Dongmins11/KickCAN_project_Controller/docs/functions.md

# 시스템 기능 명세

[README로 돌아가기](../README.md) · [원본 Excel](files/functional-spec.xlsx)

원본 Excel의 셀 내용을 Markdown 표로 옮겼습니다. 설계 당시의 값·표기이며, 실제 Controller 구현과 다른 부분은 아래에 별도로 적었습니다. 원본의 서식과 삽입 그림은 Excel 파일에서 확인할 수 있습니다.

## RC카 시스템 기능 명세서

| 노드 구분 | 기능 ID | 기능명 | 입력 인터페이스 | 주요 처리 로직 (기능 내용) | 출력 인터페이스 | 통신인터페이스 | 비고 |
|---|---|---|---|---|---|---|---|
| Controller | F-CTL-01 | RFID 기반 차량 보안 인증 (스마트키) | RC522 RFID 모듈 (SPI) | 등록된 카드/태그의 UID 값을 읽어 시동 허가(AUTH_OK) 여부 판단 | 인증 실패 시 모든 조종 명령 송신 차단 (시동 잠금) | 블루투스로 AUTH_FALE 상태 전송 | — |
| Controller | F-CTL-02 | 스마트키 인증 기반 입력 전원 인터락 | — | RFID 인증 결과에 따라 릴레이 구동<br>인증 실패 시 조작 입력 차단 | 조이스틱·스위치 입력단 전원 (게이팅된 신호) | — | — |
| Controller | F-CTL-03 | 주행 및 조향 데이터 수집 | 2축 아날로그 조이스틱 (ADC) | X축/Y축 아날로그 입력값(0~4095)을 정수형 속도(-100~100) 및 조향 각도 데이터로 매핑 | 무선 전송용 데이터 | 블루투스로 조이스틱 adc 데이터 전송 | — |
| Controller | F-CTL-04 | 차량 제어 스위치 입력 처리 | 3단 토글 스위치, 푸시 택트 스위치 (GPIO) | 좌/우 방향지시등 선택 상태 및 클락션 등 부가 기능 버튼 입력 상태 감지 | 스위치 상태 플래그 | 블루투스로 좌/우 방향지시등, 클락션 등 제어명령 전송 | — |
| Controller | F-CTL-05 | 무선 데이터 패킷 전송 | 인증 상태 / 주행·조향값 / 스위치 상태 | 패킷 가공 후 주 주기(예: 20ms) 전송 | 블루투스 모듈 HC-05 (UART) | — | 추가 |
| Controller | F-CTL-06 | 시리얼 디버깅 | 블루투스  | 각종 상태 명령 시리얼 모니터로 감시 | UART | 블루투스로 main_node에서 받은 각종 상태를 받아 uart포트로 점검한다. | 추가 |
| Main_Node | F-MAIN-01 | 무선 명령 수신 및 파싱 | 블루투스 모듈 HC-06 (UART) | 수신 패킷 검증 및 파싱 (체크섬 확인) | 내부 제어 명령 데이터 | 블루투스로 인증상태 방향지시등 비상등 클락션등 제어명령 수신 | — |
| Main_Node | F-MAIN-02 | 4WD 모터 구동 및 방향 제어 | 수신된 속도 및 조향 명령 | 속도 데이터로 PWM duty cycle 조절, 방향에 따른 정/역회전 제어 | L298N 모터드라이버 및 DC 모터 4개 (PWM, GPIO) | 블루투스로 controller에서 adc 데이터를 수신 | — |
| Main_Node | F-MAIN-03 | 배터리 전압 감시 | 18650 2S 배터리 저항 분압 회로 (ADC) | 배터리 전압(V) 및 잔량 퍼센트(%) 계산 수 100ms마다 Node_2로 전송 | 배터리 상태 데이터 | CAN으로 베터리 데이터 node_2로 전송 | — |
| Main_Node | F-MAIN-04 | 속도 측정 | 엔코더 포토커플러 | 속도 측정 후 100ms마다 측정된 속도 Node_2로 전송 | 속도 데이터 (m/s) | CAN으로 속도 데이터 node_2로 전송 | — |
| Main_Node | F-MAIN-05 | 전,후,정지 상태 업데이트 | 아날로그 스틱 or 속도 | 아날로그 스틱 혹은 속도를 측정하여 전진 후진 정지 감지 | 전진 후진 정지  | CAN으로 전진 후진 정지 상태 node2로 전송 | 추가 |
| Main_Node | F-MAIN-06 | CAN 전송 | 데이터 패킷 | 수십 ms 주기로 CAN 메시지 방송 | 캔 트렌시버 | — | — |
| Main_Node | F-MAIN-07 | CAN node 연결 상태 확인 | node ACK신호  | 모든 노드의 아이디로 cheak명령 전송 | 캔 트렌시버 | CAN으로 모든 노드 cheak명령 전송 및 블루투스로 통신 연결 상태 전송 | 추가 |
| Node_1 | F-SEN-01 | 모터 온도 감시 및 Thermal Throttling | TMP36(ADC) | 모터 컨트롤러 표면 온도(°C) 계산, 위험 온도(60°C 이상) 진입 시 과열 경고 전송 | CAN 버스 메시지 (과열 경고) | CAN으로 과열 경고  node_2로 전송 | — |
| Node_1 | F-SEN-02 | 2채널 오토 라이트 (Auto Light) 환경 감지 | 전방 CdS 센서 + 상부 CdS 센서 (ADC) | 전방 광량과 상부 광량 비교 분석하여 터널 진입 및 밤/낮 상태 판별 | CAN 버스 메시지 (헤드라이트 제어) | CAN으로 조도 상태(어두움, 밝음)  node_2로 전송 | — |
| Node_1 | F-SEN-03 | 전후방 장애물 거리 측정 | HC-SR04 초음파 센서 2개 (TIM_IC / GPIO) | 앞/뒤 센서 거리(cm) 정밀 측정 | 전후방 거리 데이터 | CAN으로 장애물에 대한 1, 2, 3단계 상태  node_2로 전송 | — |
| Node_1 | F-SEN-04 | CAN 전송 | 데이터 패킷 | 수십 ms 주기로 CAN 메시지 방송 | 캔 트렌시버 | — | — |
| Node_1 | F-SEN-05 | CAN node 연결 상태 확인 | node ACK신호  | 모든 노드의 아이디로 cheak명령 전송 | 캔 트렌시버 | main에서 cheak명령 수신 및 ack 전송 | 추가 |
| Node_2 | F-HCI-01 | TFT 메인 그래픽 클러스터 렌더링 | CAN 버스 수신 데이터 (속도/배터리/방향지시등) | 속도계, 배터리 잔량 바, 방향지시등 화살표 아이콘 실시간 그래픽 출력 | 2.2인치 240x320 TFT LCD ×2 (SPI) | 속도, 배터리 데이터를 main_node에서 수신 | — |
| Node_2 | F-HCI-02 | CLCD 서브 정보창 출력 | CAN 버스 수신 데이터 (온도/초음파거리/스마트키상태) | 모터 온도(°C) 상태, 초음파 거리(cm), 스마트키 상태(LOCKED/WELCOME) 텍스트 및 이미지 출력 | 16x2 I2C CLCD (I2C) | 센서 데이터를 node_1에서 수신 | — |
| Node_2 | F-HCI-03 | 턴 시그널 및 오토라이트 제어 | CAN 버스 수신 데이터 (방향지시등/오토라이트 명령) | 방향지시등 좌/우 점멸, 헤드라이트(오토라이트) 점등 | 방향지시등 빨간색 LED (좌/우)<br>헤드라이트 노란색 LED (좌/우) | 제어 명령를 main_node에서 수신 | — |
| Node_2 | F-HCI-04 | 청각 경고음 출력 (Fail-safe 피드백) | CAN 버스 수신 데이터 (과열경고/초근접/스마트키인증) | 모터 과열 경고, 후방 초근접(20cm 이내), 인증 성공/실패 시 비프음 출력 | 부저 | 센서 데이터를 node_1에서 수신 | — |
| Node_2 | F-HCI-05 | CAN 전송 | 데이터 패킷 | 수십 ms 주기로 CAN 메시지 방송 | 캔 트렌시버 | — | 추가 |
| Node_2 | F-MAIN-06 | CAN node 연결 상태 확인 | node ACK신호  | 모든 노드의 아이디로 cheak명령 전송 | 캔 트렌시버 | main에서 cheak명령 수신 및 ack 전송 | 추가 |

## 현재 코드와의 차이

Controller 원본의 0–4095 및 -100–100 매핑 설명은 현재 코드와 다릅니다. 현재 코드는 10-bit ADC(0–1023), EMA 필터와 끝값 보정을 사용합니다. 인증 실패 알림은 최초 잠금 상태와 연결 이후 실패 상태에 따라 다릅니다. F-CTL-06은 원본의 계획 항목이며 Bluetooth 테스트 Task의 호출은 현재 주석 처리되어 있습니다. 전체 노드의 모든 계획 항목을 구현 완료로 간주하지 않습니다.
