Dongmins11/KickCAN_project_Controller/docs/files/presentation.pdf

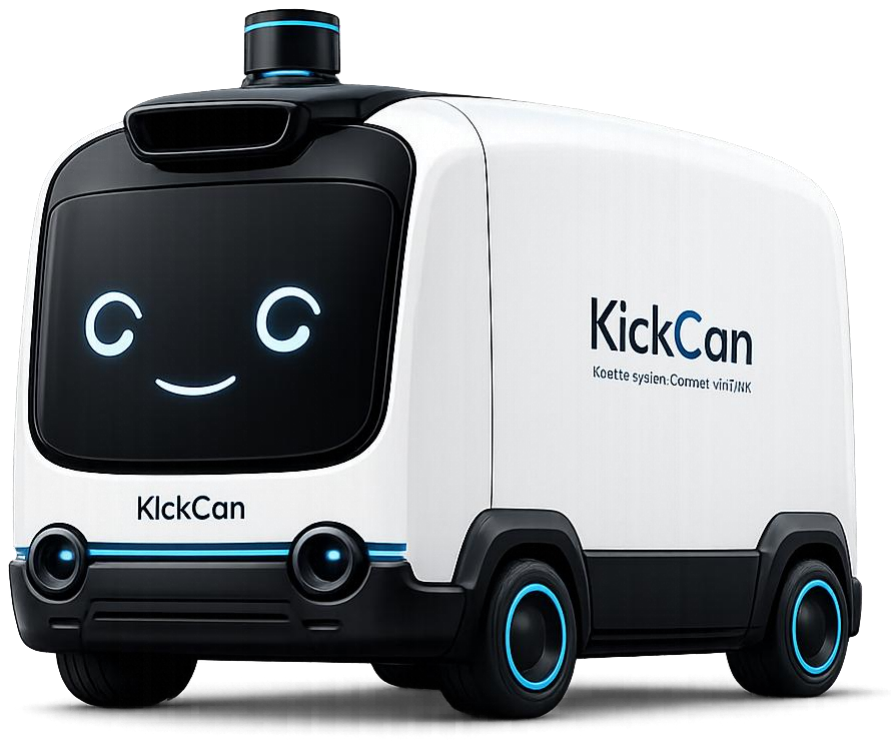
[picture p11: figure]

## Cortex

M

## Mini PROJECT

CAN 통신을 이용한 RC

카

팀명 : 깡통차기 [Kick CAN]

CAN
SENSOR
FreeRTOS
Bluetooth
ADC
DMA
PWM

목 차

### 01 프로젝트 소개

### 02 시연 영상

### 03 프로젝트 상세 내용

### 04 CAN 통신

### 05 트러블 슈팅 사례

### 06 향후 과제

### 07 Q & A

# 01 프로젝트 소개

프로젝트 소개

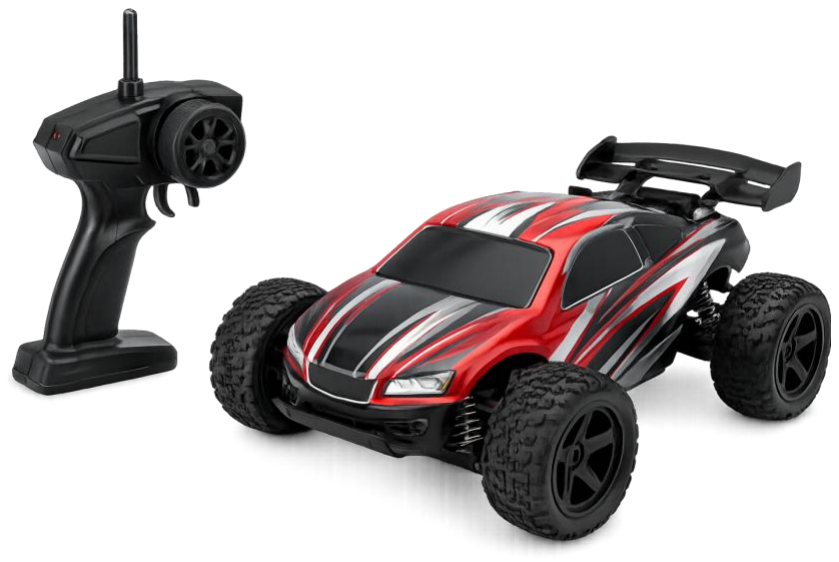
[picture p12: figure]

원격 주행이 가능한 기존의 RC카

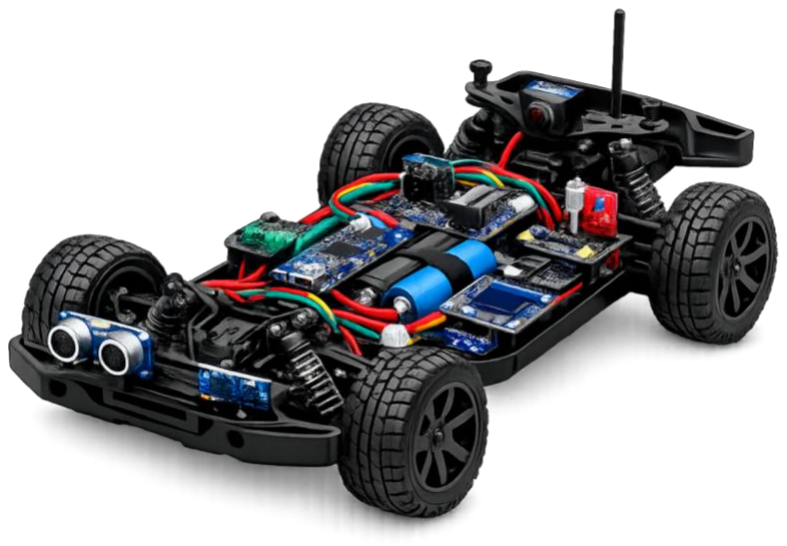
[picture p13: figure]

실제 차량의 전장 시스템을 모사
운전자 입력, 차량 제어,
주변 환경 감지, 경고 및 정보 표시

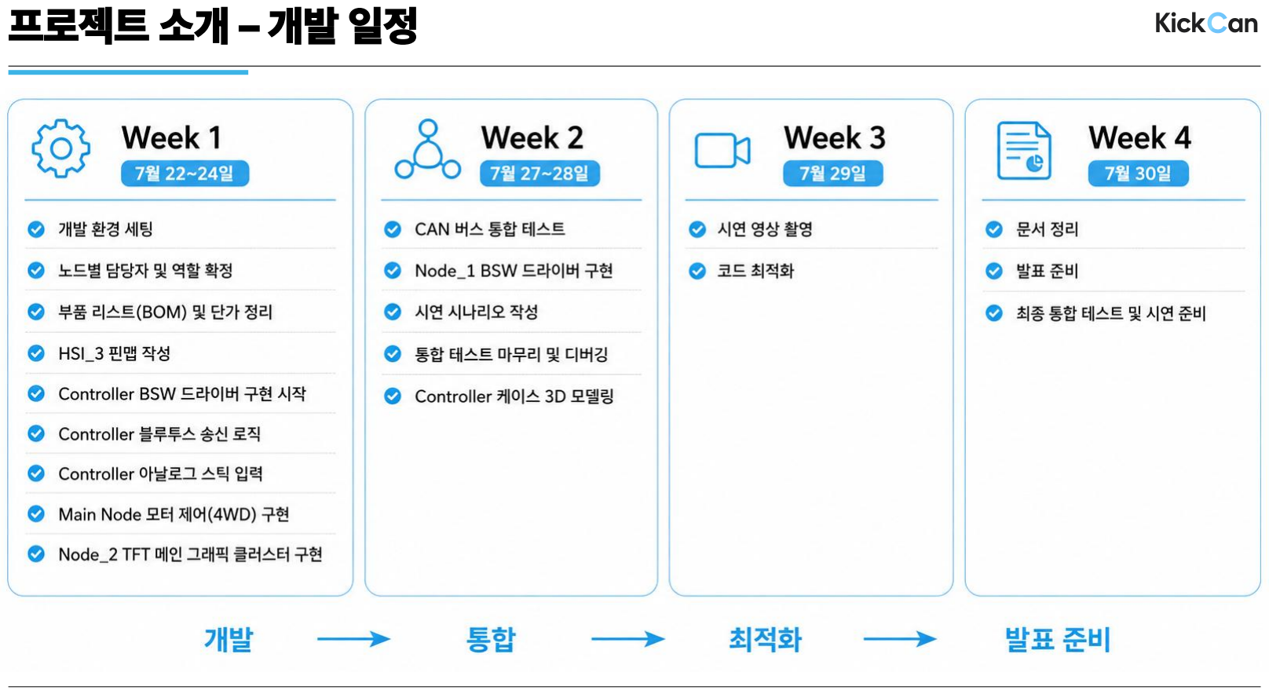
[picture p14: page 5]

프로젝트 소개 – 개발 일정

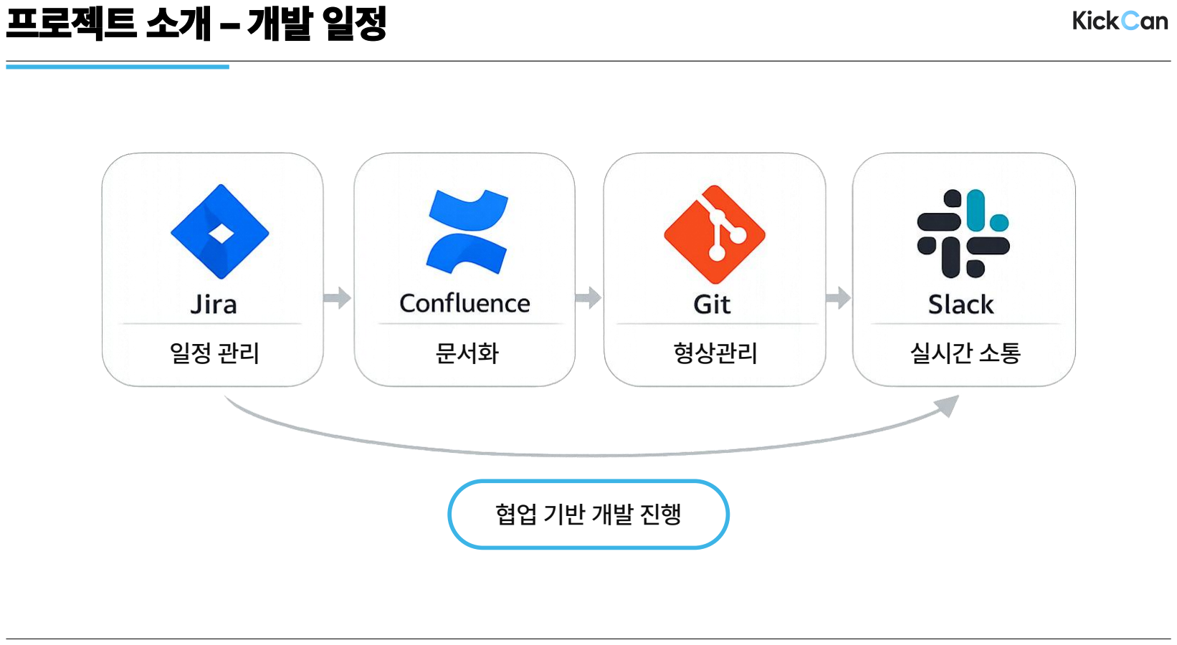
[picture p15: page 6]

프로젝트 소개 – 개발 일정

일정 관리 | 문서화 | 형상관리 | 실시간 소통

협업 기반 개발 진행

프로젝트 소개 - 팀원

최은비
[Node 1]
✓ | 초음파 , 온도 등 센서 데이터 수집
✓ | FreeRTOS 기반 Task 구조
✓ | CAN 송신 데이터 관리

최세은
[Node 2]
✓ | TFT·CLCD 차량 상태 시각화
✓ | PWM 기반 헤드라이트·부저 제어
✓ | CAN 수신 데이터 기반 경고·상태
| 관리

신동민
[Controller]
✓ | 주행 및 조향 데이터 수집
✓ | 차량 제어 스위치 입력 처리
✓ | RFID 기반 차량 보안 인증

이정훈
[Main Node]
✓ | 통신 관련 명령 수신 및 파싱
✓ | 4WD 구동 제어
✓ | 상태 감시 및 공유

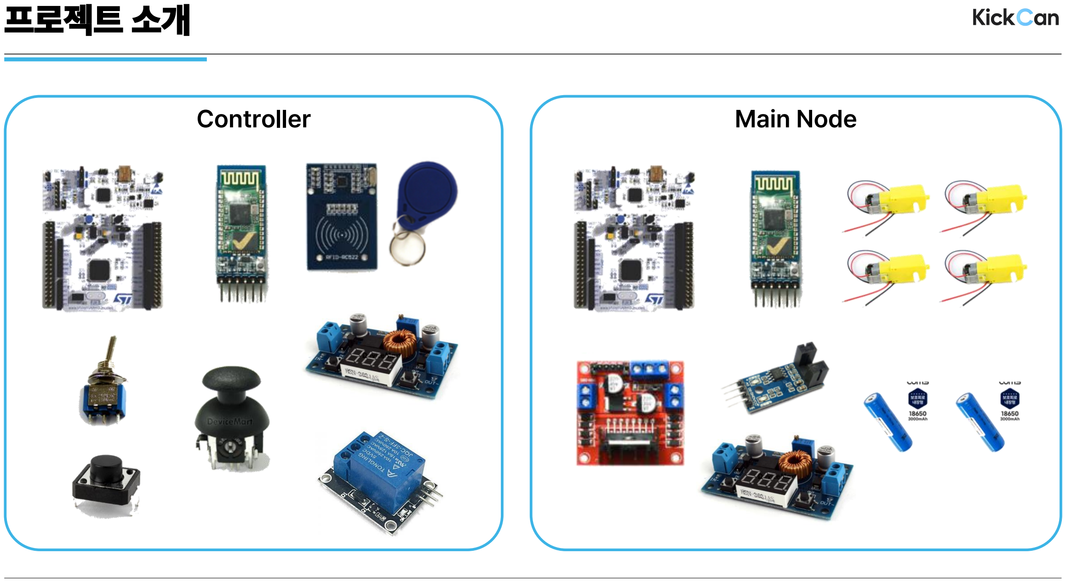
[picture p16: page 8]

프로젝트 소개

Controller | Main Node

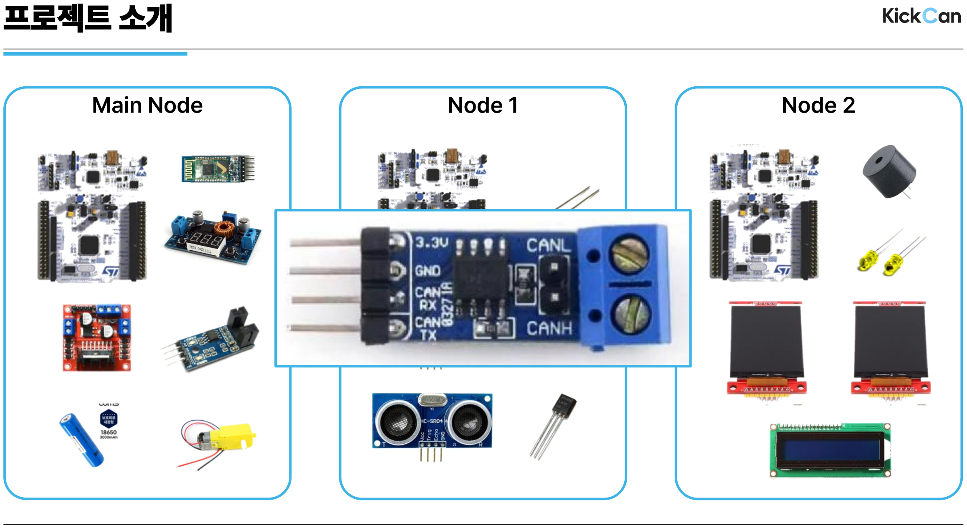
[picture p17: page 9]

프로젝트 소개

Main Node | Node 1 | Node
2

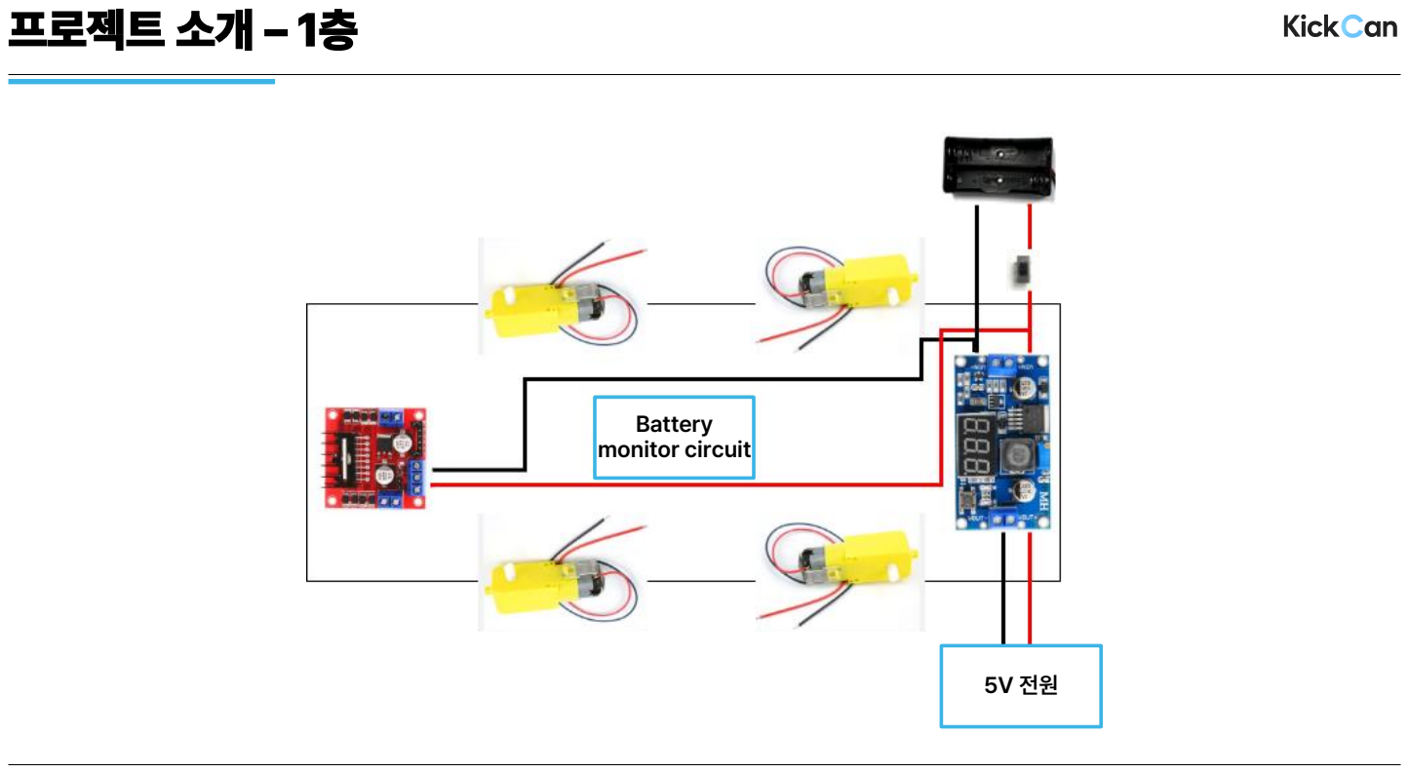
[picture p18: page 10]

프로젝트 소개 – 1층

Battery
monitor circuit

5V 전원

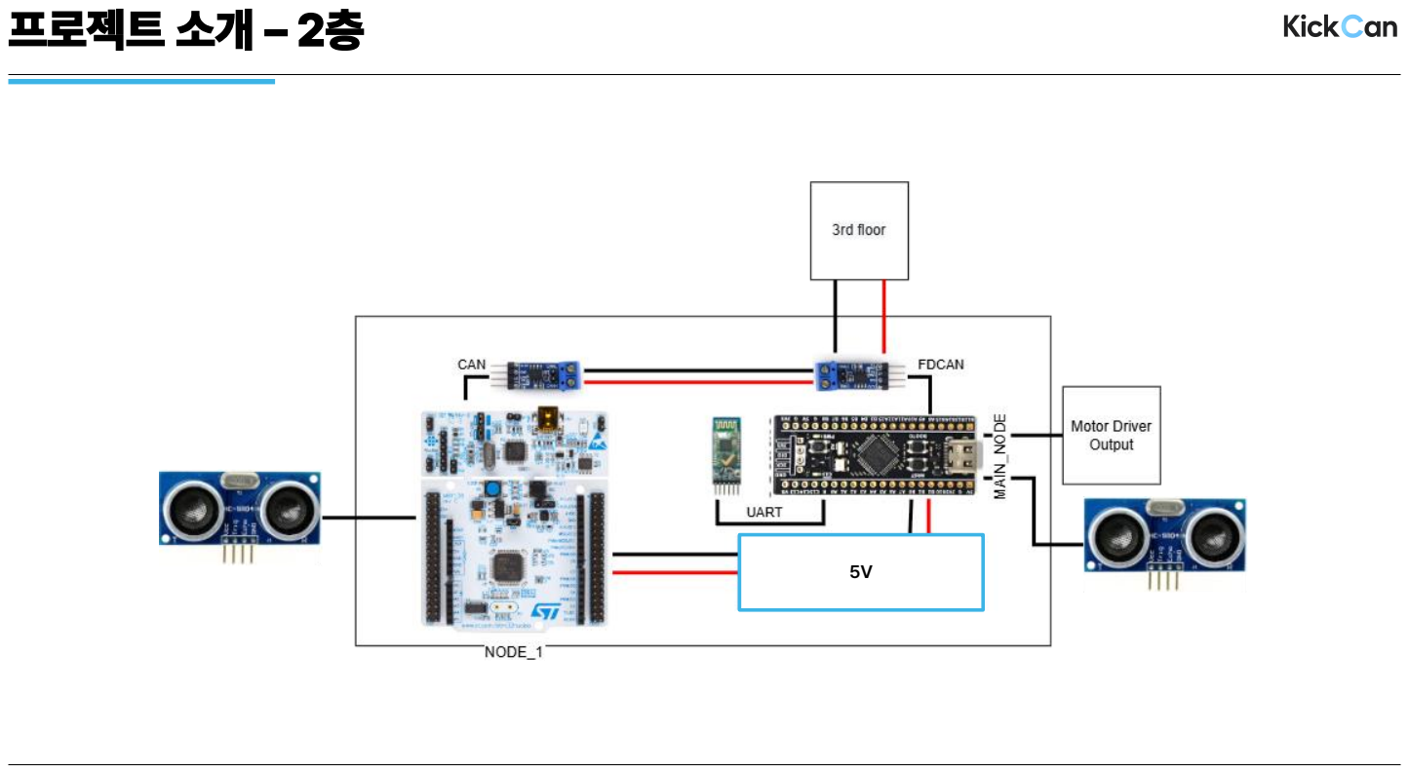
[picture p19: page 11]

프로젝트 소개 – 2층

5V

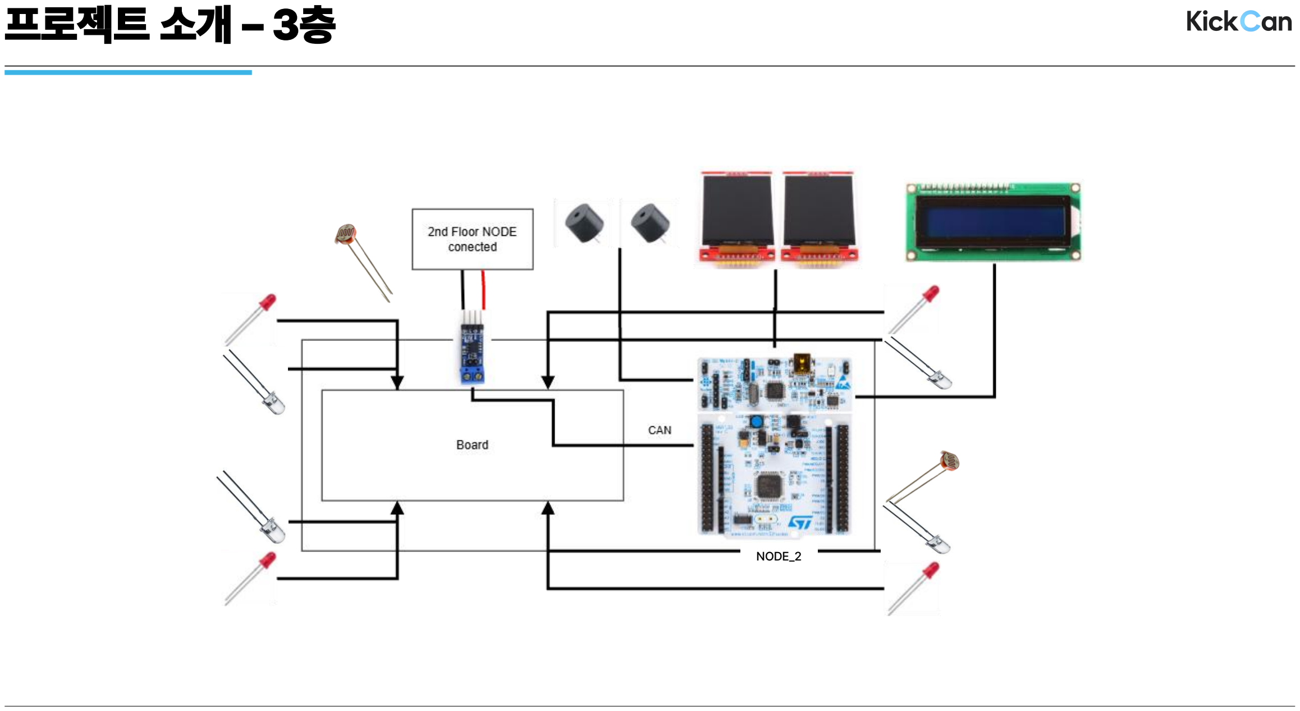
[picture p20: page 12]

프로젝트 소개 – 3층

NODE_2

프로젝트 소개 – 문서 작업 [BOM / 기능명세서]

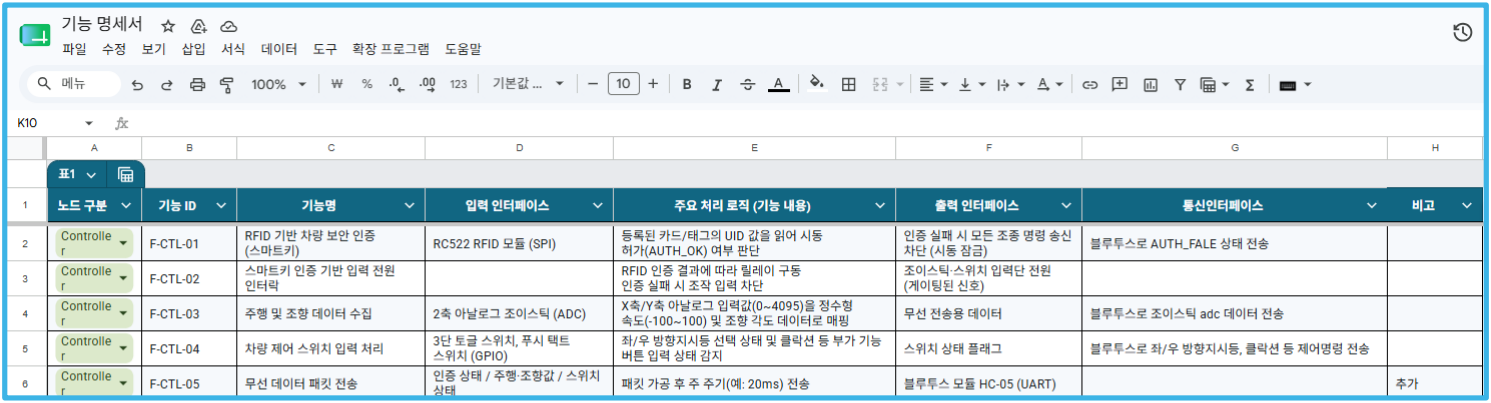
[picture p21: figure]

프로젝트 소개 – 문서 작업 [핀맵 / ICD]

# 02 시연 영상

시연 영상 - 기능별

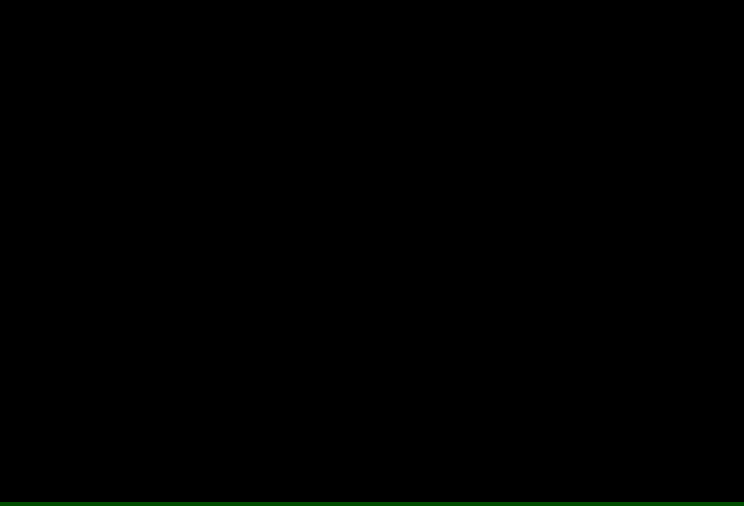
[picture p22: figure]

시연 영상 – 전체 주행

# 03 프로젝트 상세 내용

프로젝트 상세 내용 – Main Node

하드웨어 시스템 인터페이스 (HSI)
시스템의 중앙 두뇌 역할을 하며, 통신과 물리적 구동을 통합 관리합니다.

MCU: 전체 로컬 처리 및 제어 루프 관장
UART(BLUETOOTH): 컨트롤러와 무선 명령 송수신(HC-05) FDCAN: NODE 1, NODE 2와 고속 센서 데이터 공유 MOTOR SENSORS: 엔코더(TIM_IC), 배터리 전압(ADC) 측정
DRIVER: 4WD 시스템 PWM 구동 (L298N)

프로젝트 상세 내용 – Main Node

MAIN NODE 주요 역할

명령 수신 및 파싱

블루투스를 통해
조이스틱 X/Y 값 및 보조 명령
(경적, 방향지시등)을 수신하고,
패킷을 검증(CheckSum)하여
파싱합니다 .

4WD 구동 제어

수신된 속도/조향 데이터로
좌우 모터의 차동 구동
(Differential Drive)을
위한 PWM Duty Cycle을
계산하고 제어합니다 .

상태 감시 및 공유

엔코더 기반 속도(cm/s) 측정 및
배터리 전압(ADC) 측정과
컨트롤러 제어명령을
CAN 버스를 통해 각 노드로
데이터를 전송합니다.

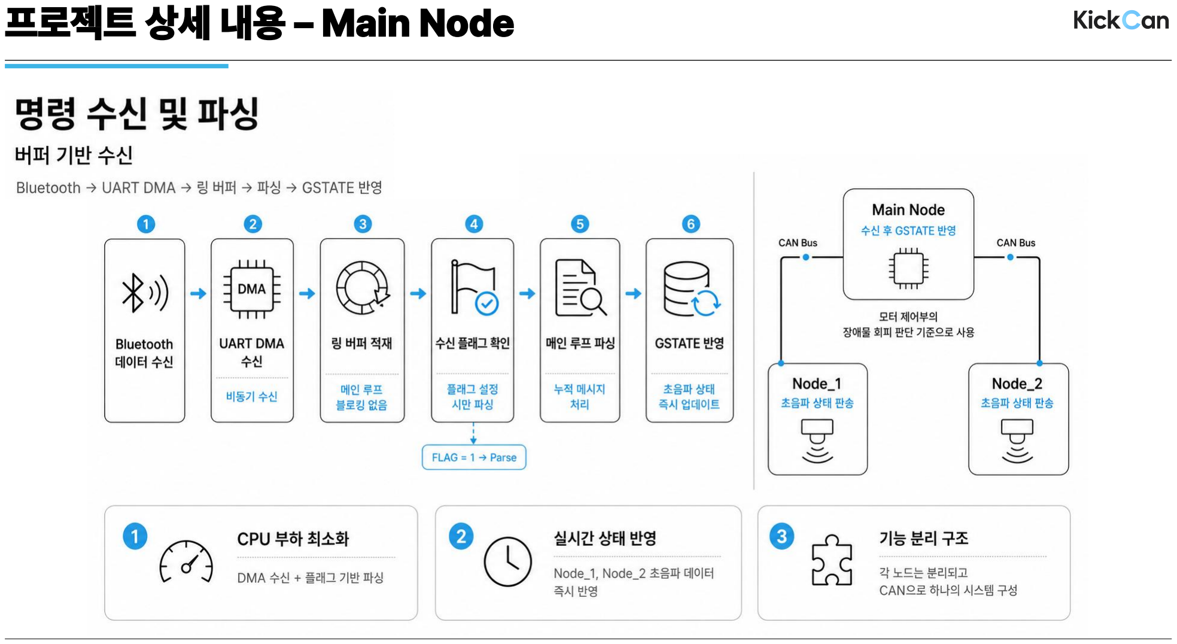
[picture p23: page 21]

프로젝트 상세 내용 – Main Node

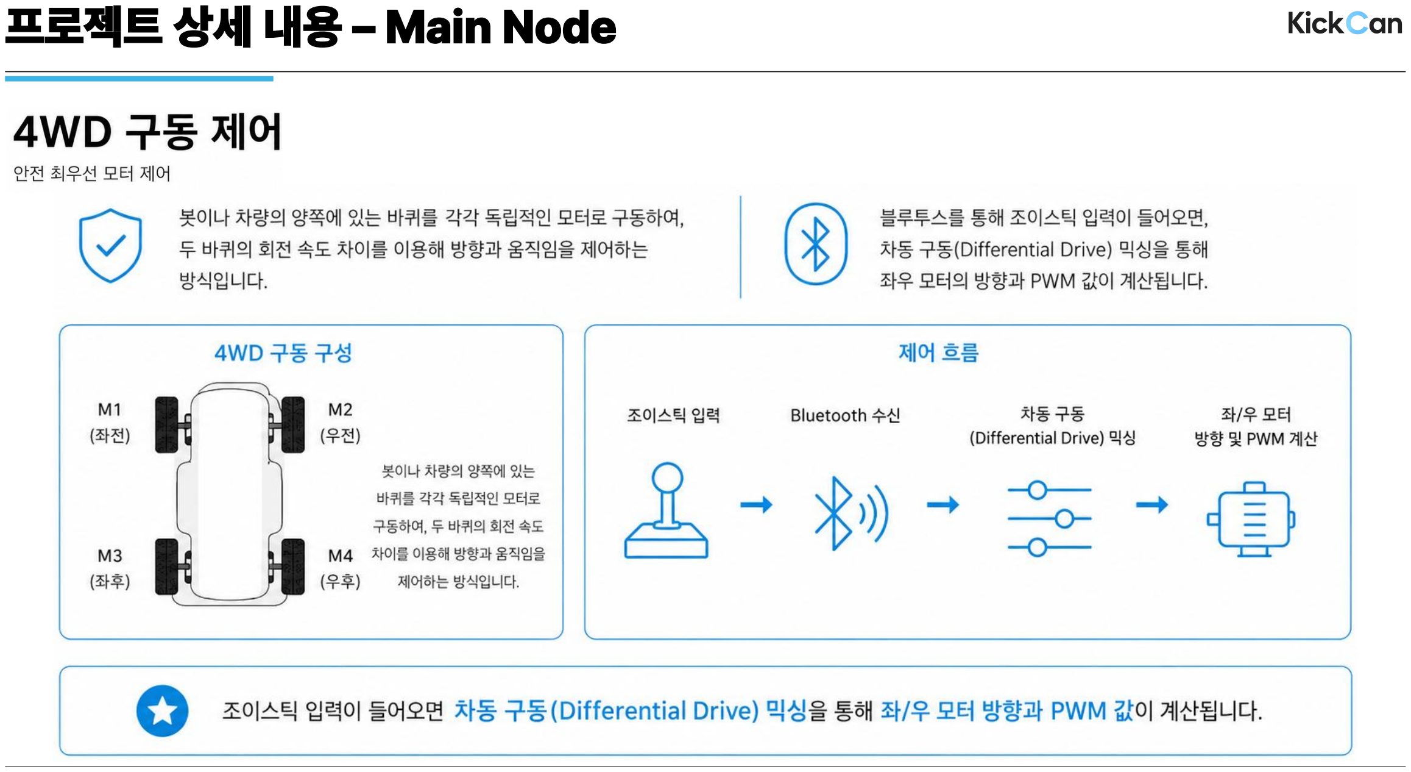
[picture p24: page 22]

프로젝트 상세 내용 – Main Node

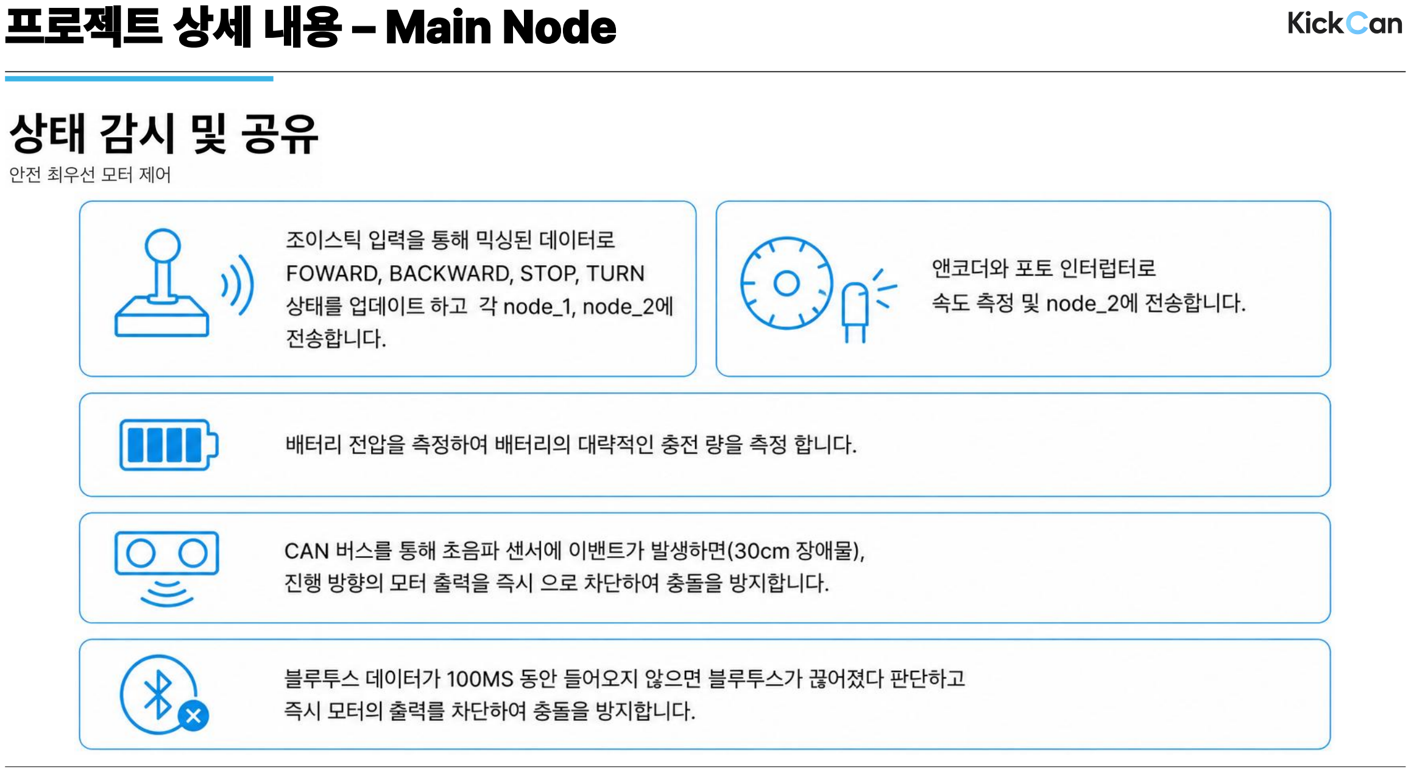
[picture p25: page 23]

프로젝트 상세 내용 – Main Node

프로젝트 상세 내용 – Controller

조이스틱입력 | RFID 인증 | 스위치제어 | 무선통신
ADC DMA 방식으로 2축 조이스틱 값을 연속 수집합니다. 인터페이스: ADC | RC522 모듈로 카드 UID를 읽어 사용자 인증을 처리합니다.
| 인터페이스: SPI | 3단 토글 스위치와 택트 스위치를 GPIO 인터럽트로 처리합니다.
| | 인터페이스: GPIO | HC-05 모듈로 RC카에 제어 패킷을 무선 송신합니다.
| | | 인터페이스: UART

프로젝트 상세 내용 – Controller

ADC DMA 기반 조이스틱 입력

Circular DMA를 통해 조이스틱 X Y 값을 지속적으로 갱신하고
반복적인 ADC 인터럽트 처리를 줄여
안정적인 조향 데이터 수집 구조를 구현

DMA 사용이유

X축/Y축 아날로그 입력값을
STM32의 ADC를 사용해
아날로그 값을 디지털 값(0~1023)으로 변환하고, Circular DMA를 사용해 측정값을 메모리에 지속적으로 저장

조이스틱 입력

프로젝트 상세 내용 – Controller

조이스틱 입력 안정화

조이스틱 값이 사용자가 움직이지 않고 중앙에
놓아두더라도ADC 값이 미세하게 변했습니다.

그래서 조이스틱 원시값을 그대로 RC카에 전송하면 작은 ADC 변화가 계속 조향 명령에 반영되어 차량의 방향이 미세하게흔들릴 가능성이있다 판단,

이를 개선하기 위해 현재 ADC 값을 즉시 사용하지 않고 이전 측정 결과와 누적하여 반영하는 필터를 적용했으며 마지막으로 최대 최소값을 제한해서
데이터를구성했습니다.

프로젝트 상세 내용 – Node 1

Node_1 역할 센서 수집 · 판단 · CAN 전송

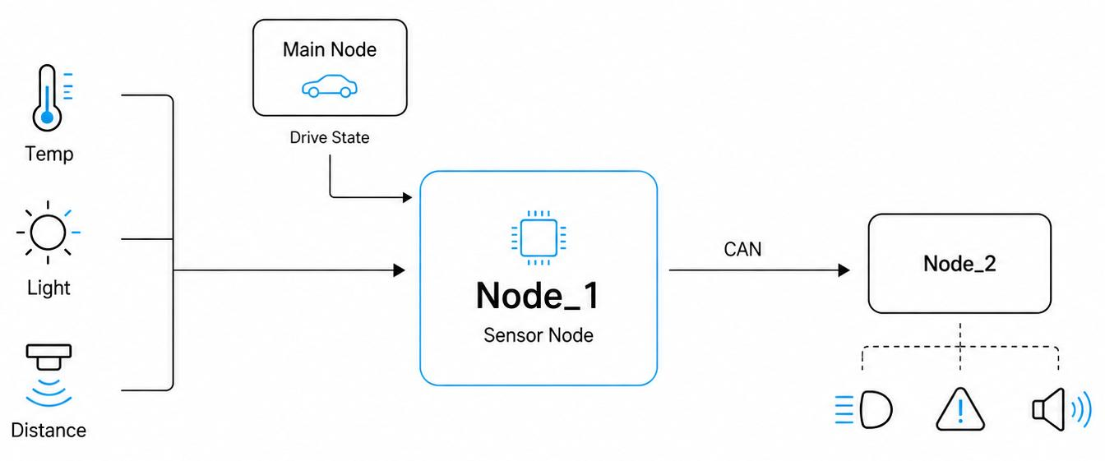
[picture p26: figure]

프로젝트 상세 내용 – Node 1

전체 동작 구조

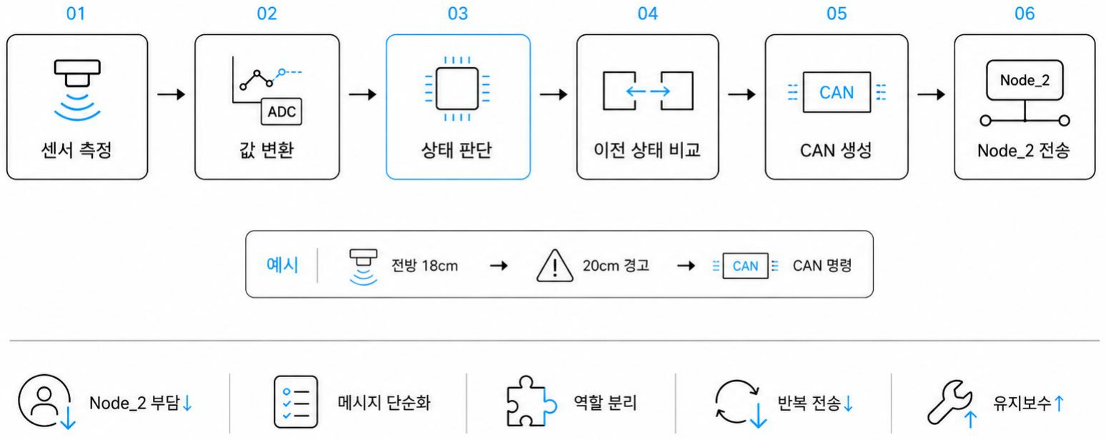
[picture p27: figure]

프로젝트 상세 내용 – Node 1

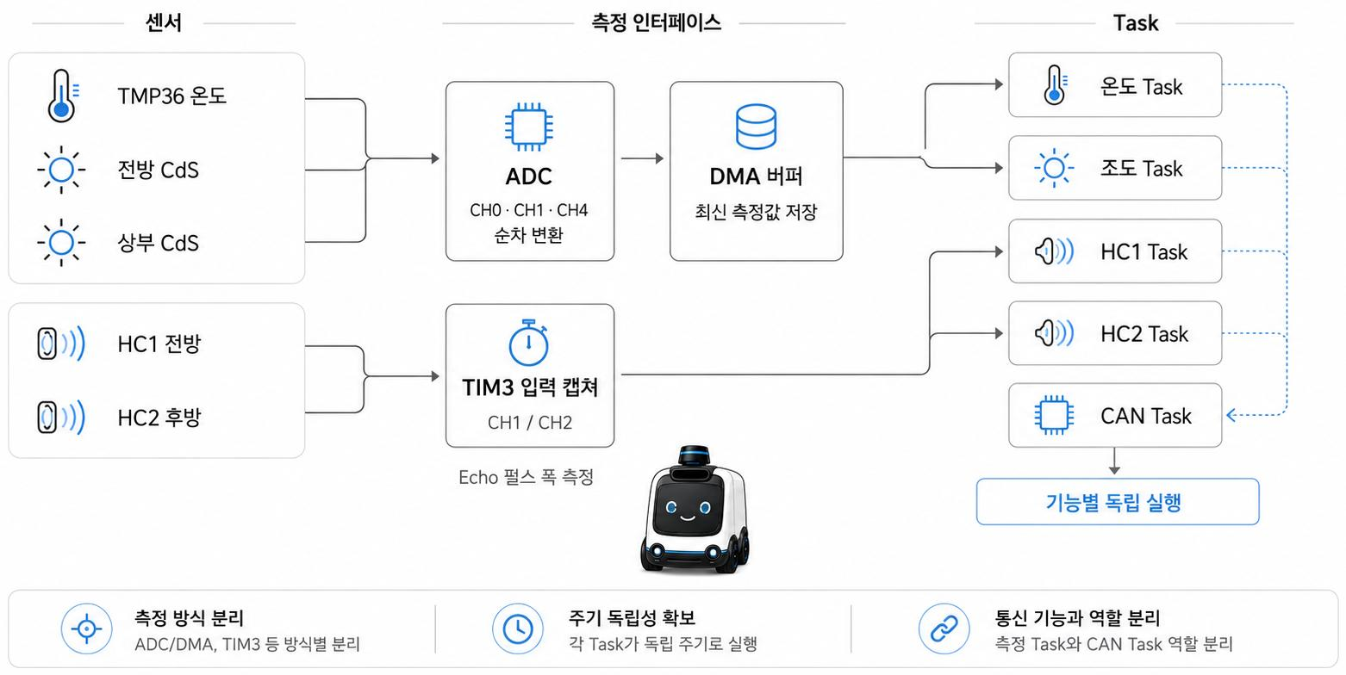
[picture p28: figure]

FreeRTOS Task로 분리하여 독립적으로 처리

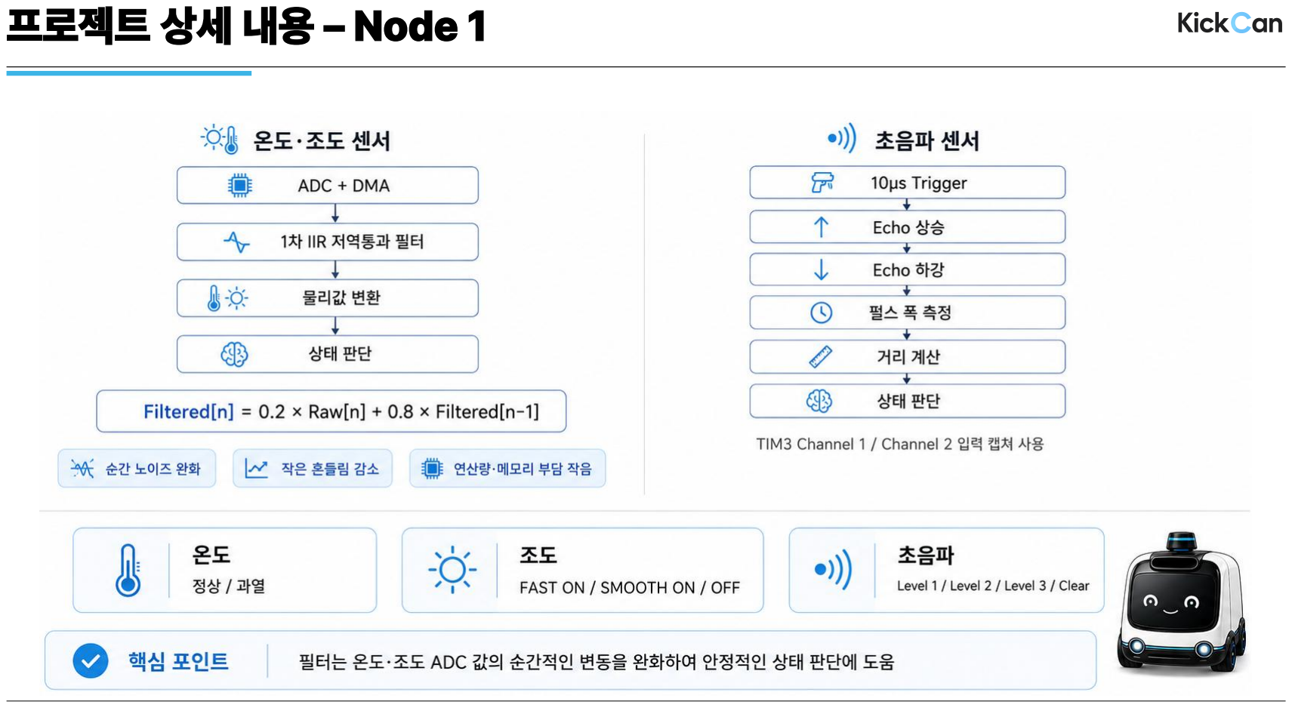
[picture p29: page 30]

프로젝트 상세 내용 – Node 1

프로젝트 상세 내용 – Node 1

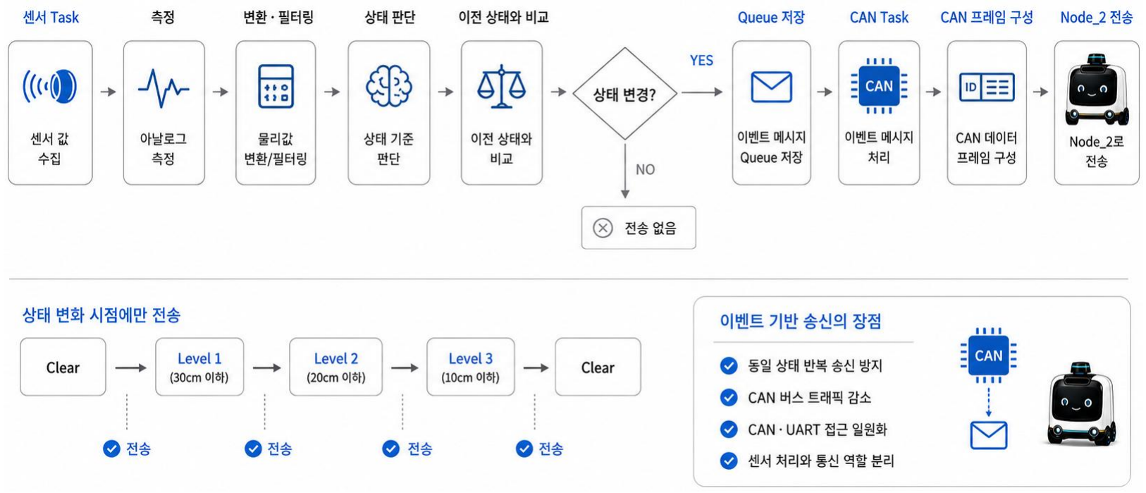
[picture p30: figure]

상태가 바뀔 때만 Queue를 통해 CAN Task로 전달

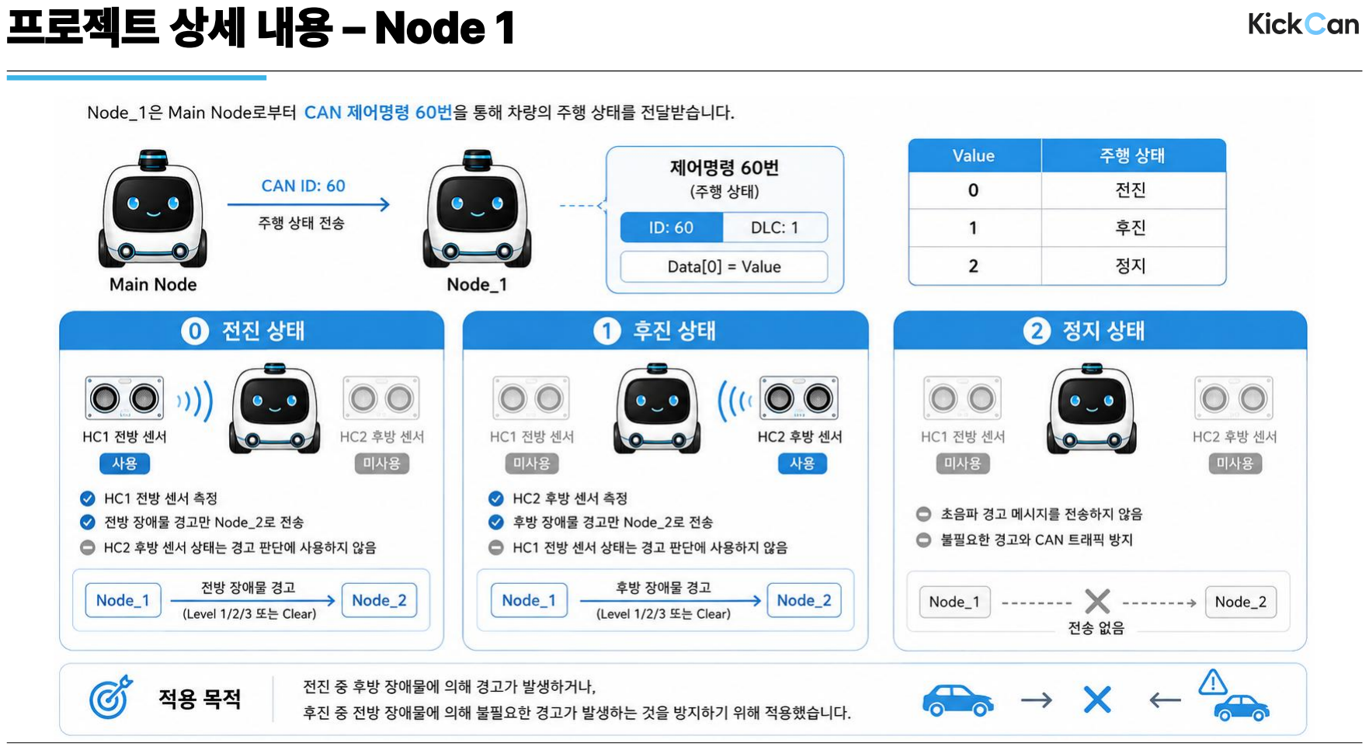
[picture p31: page 32]

프로젝트 상세 내용 – Node 1

프로젝트 상세 내용 – Node 2

NODE 2는 MAIN NODE와 NODE 1에서 CAN으로 전달된 데이터를 받아서 TFT와 CLCD에 차량 상태를 표시하고 방향지시등, 헤드라이트, 클락션 및 경고용 부저를 제어하는 역할을 담당합니다.

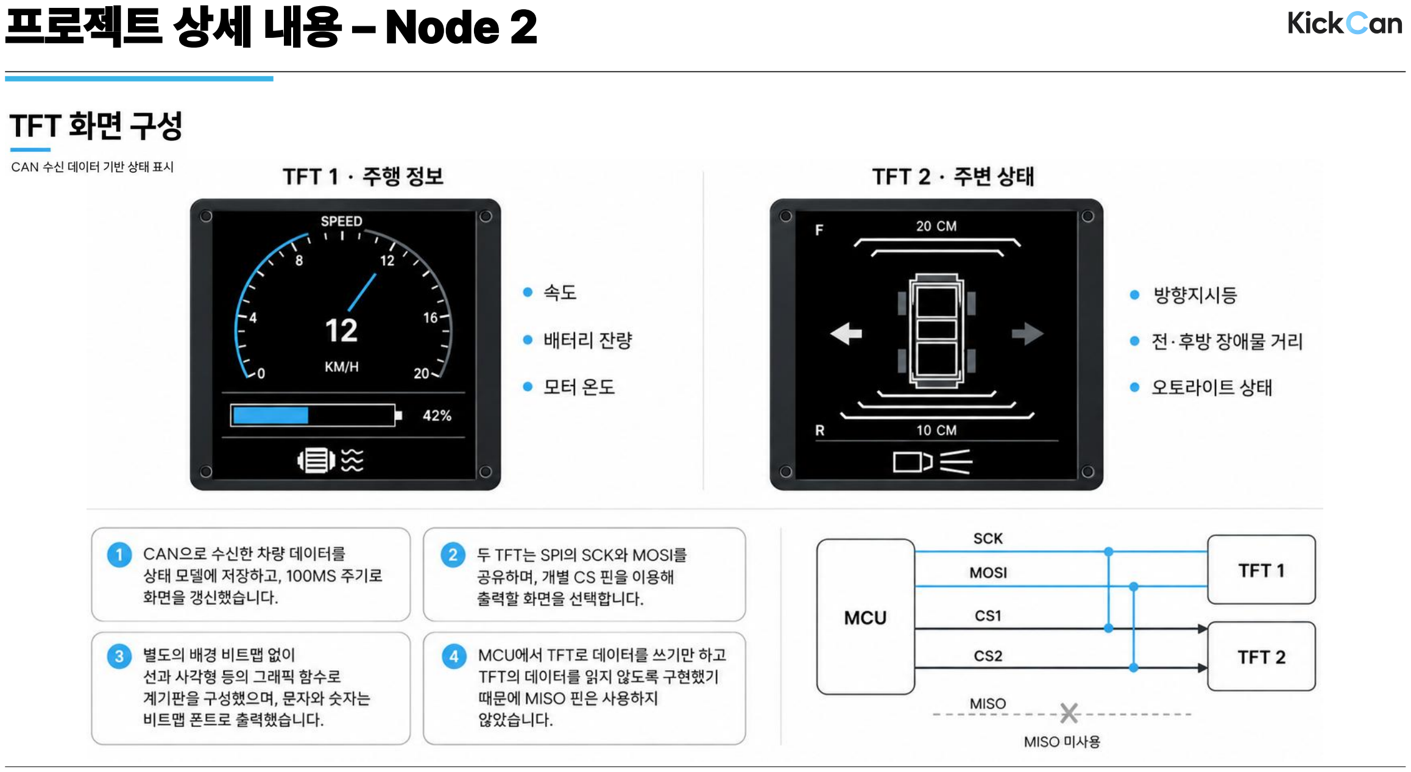
[picture p32: page 34]

프로젝트 상세 내용 – Node 2

프로젝트 상세 내용 – Node 2

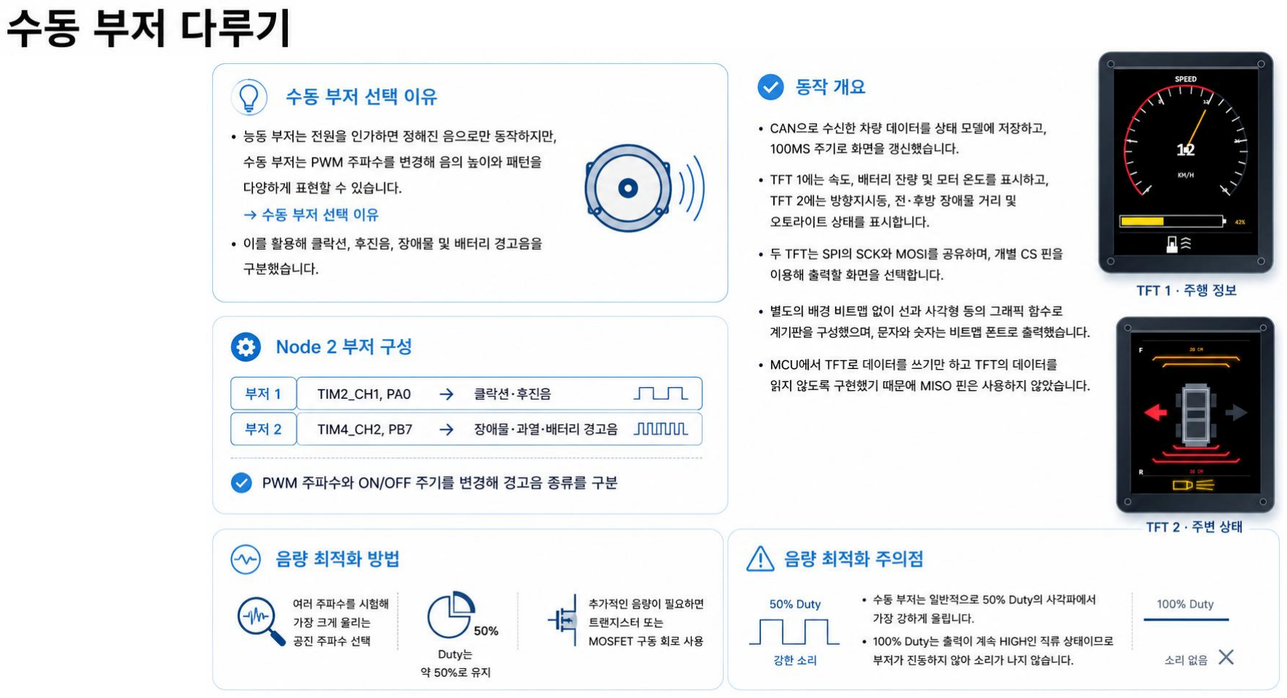
[picture p33: figure]

# 04 CAN 통신

CAN 통신 – CAN 통신의 기본 구조

Broadcast 기반 차량 네트워크

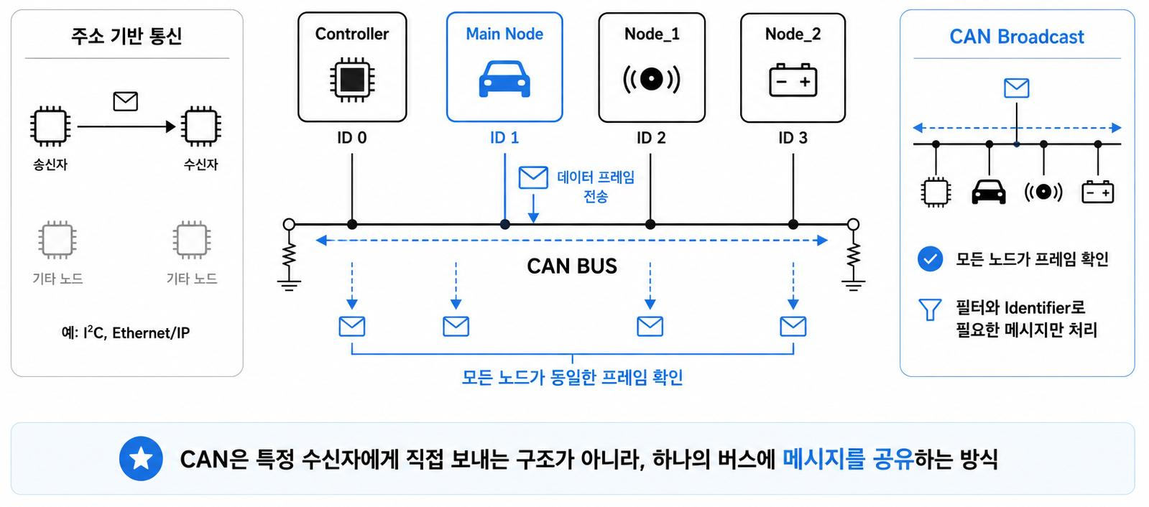
[picture p34: figure]

CAN 통신 - 프레임과 표준 동작

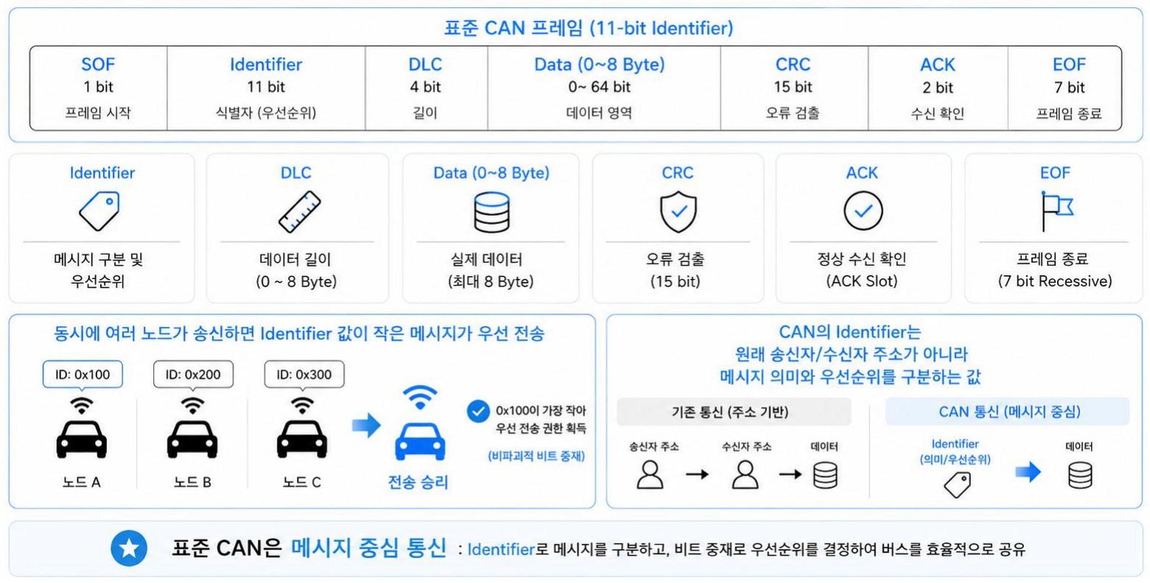
[picture p35: figure]
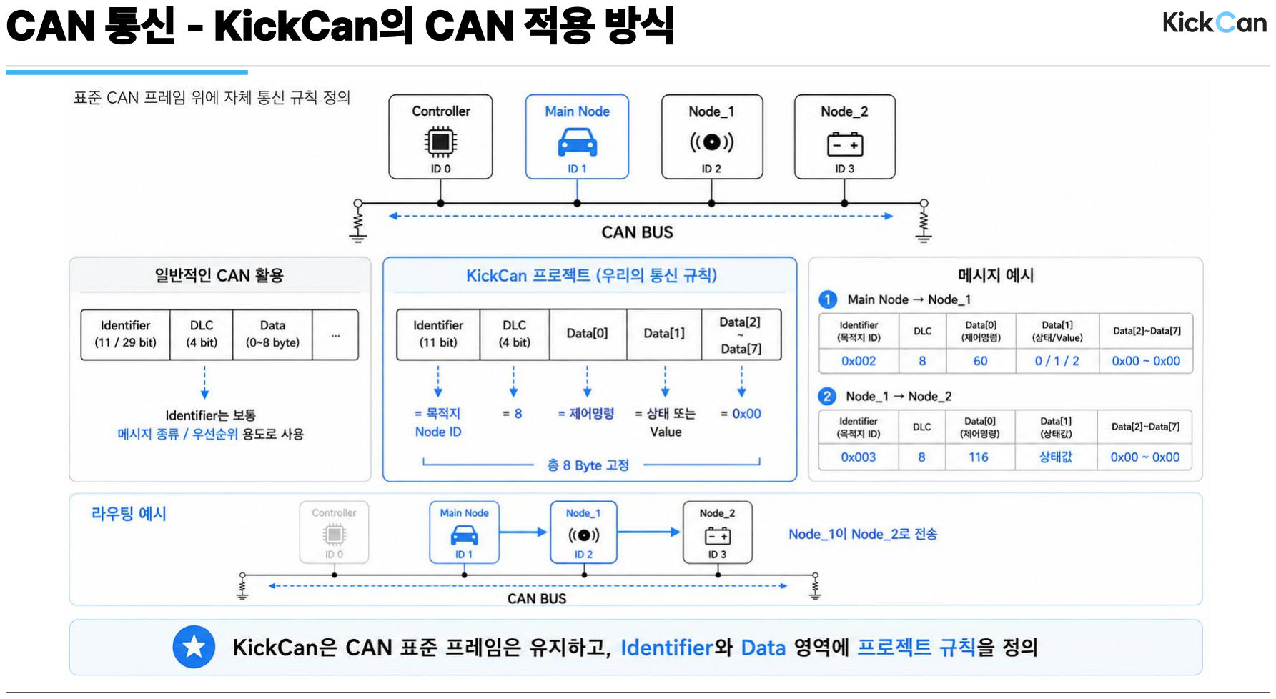
[picture p36: page 39]

CAN 통신 - KickCan의 CAN 적용 방식

# 05 트러블 슈팅 사례

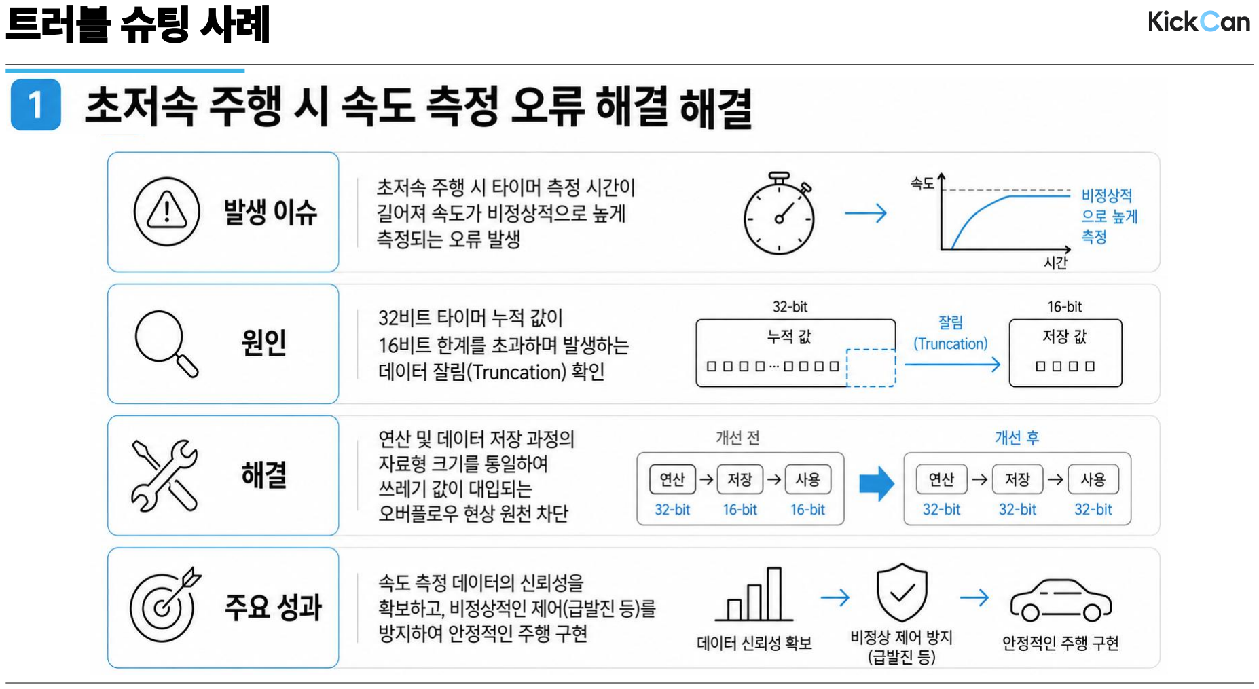
[picture p37: page 41]

트러블 슈팅 사례

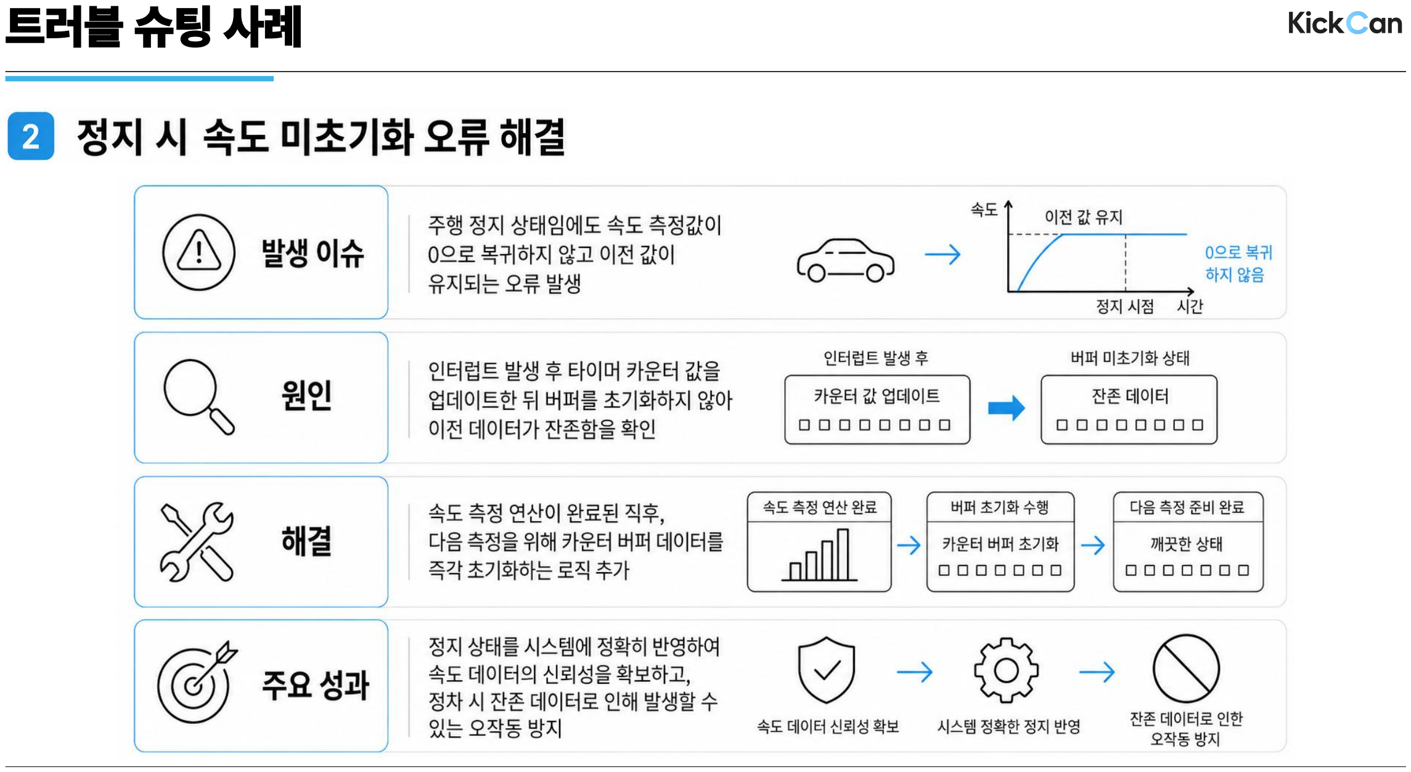
[picture p38: page 42]

트러블 슈팅 사례

트러블 슈팅 사례

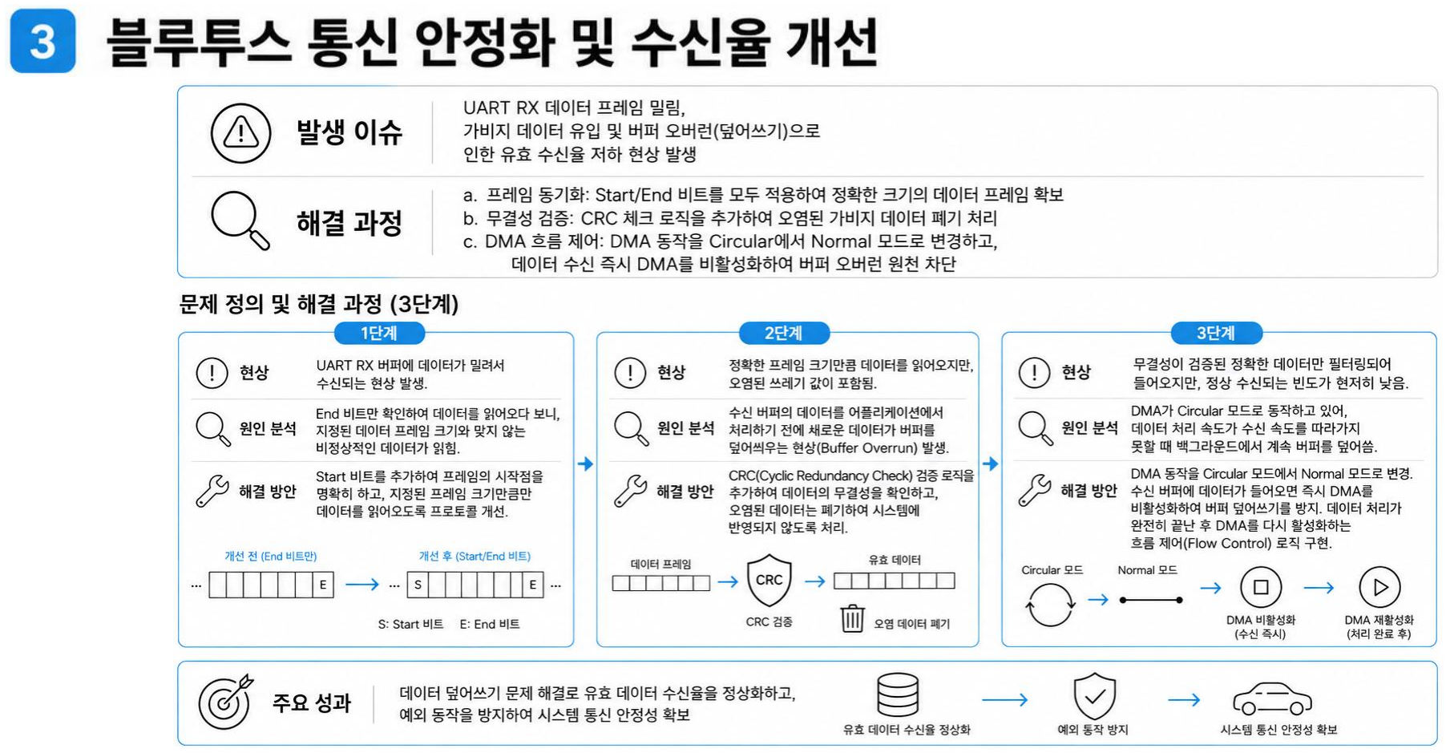
[picture p39: figure]
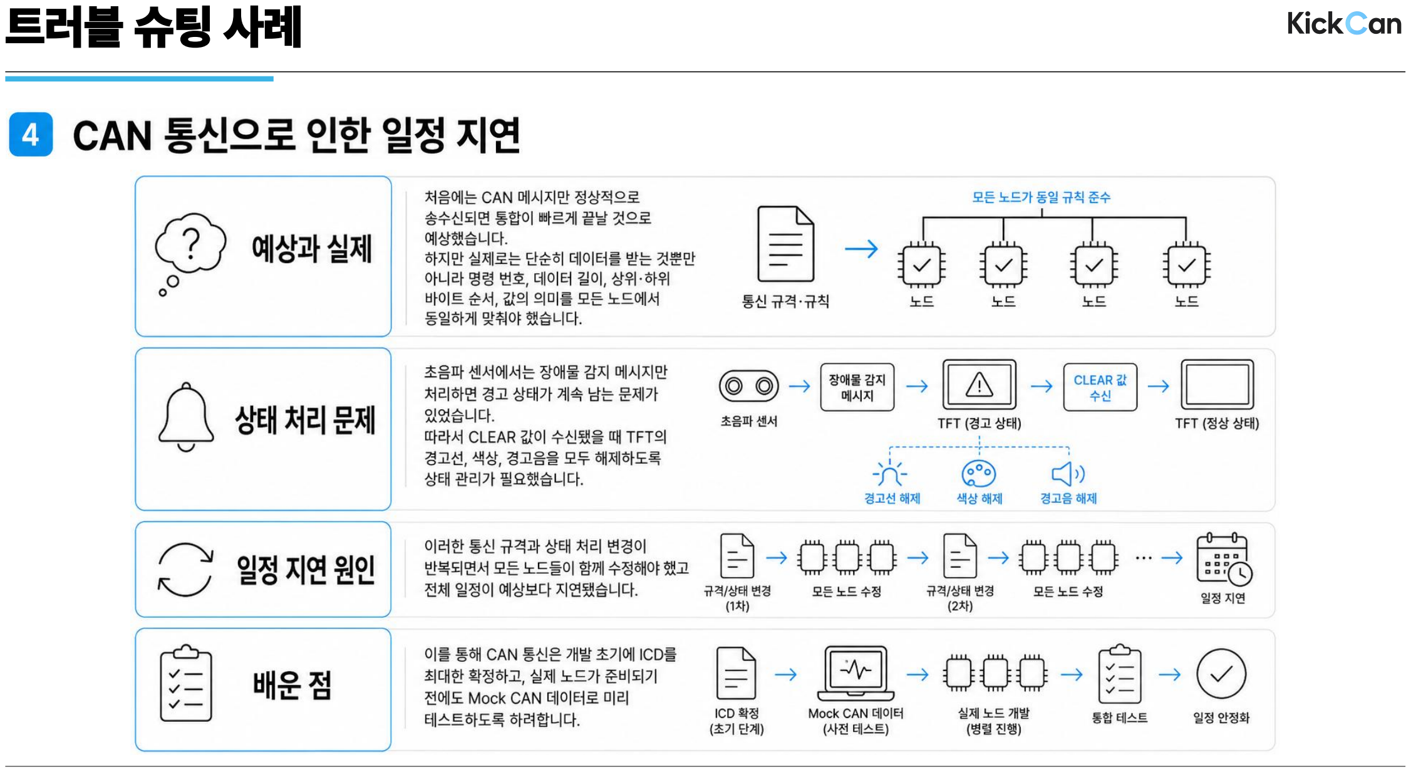
[picture p40: page 44]

트러블 슈팅 사례

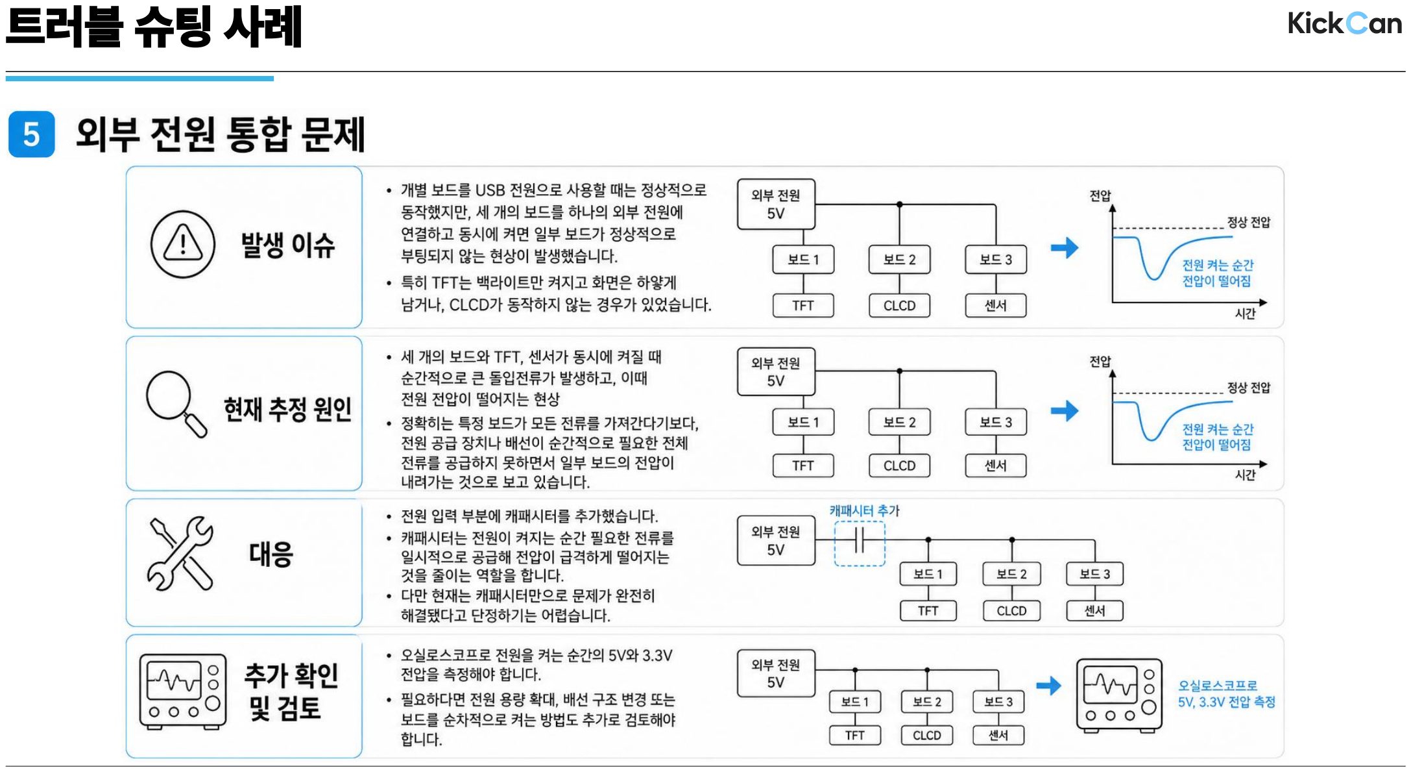
[picture p41: page 45]

트러블 슈팅 사례

# 06 향후 과제

향후 과제 – 발전 방향

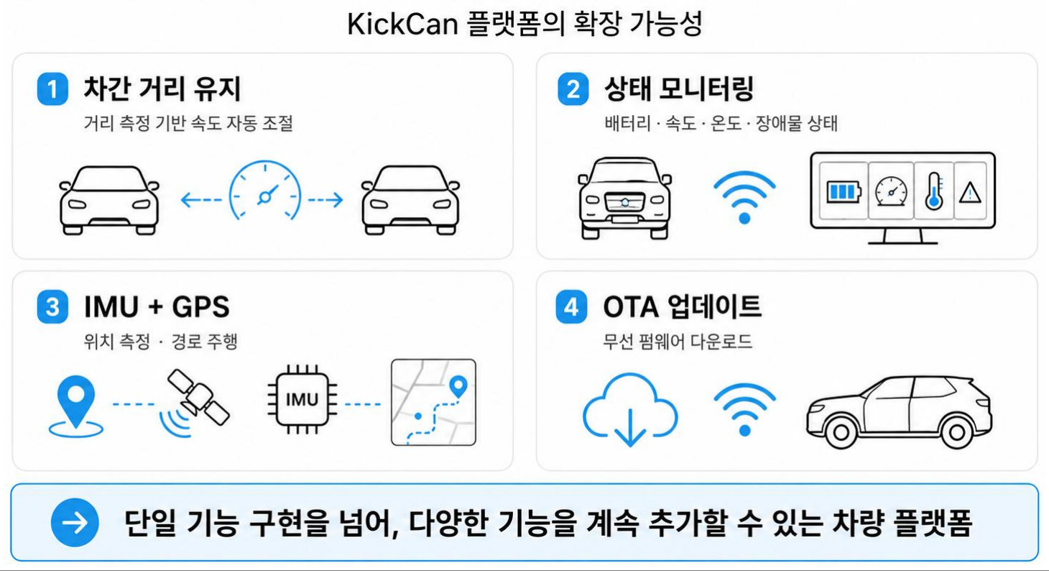
[picture p42: figure]

프로젝트 소감

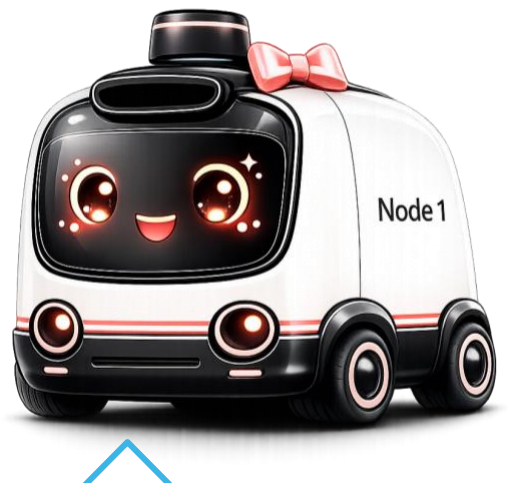
[picture p43: figure]

최은비
: 단순히 기능을 사용하는
것에서 그치지 않고,
각 통신 방식을 어떤 상황에서
활용하고 응용해야 하는지
고민해 볼 수 있어
더욱 의미 있는 경험이었습니다.

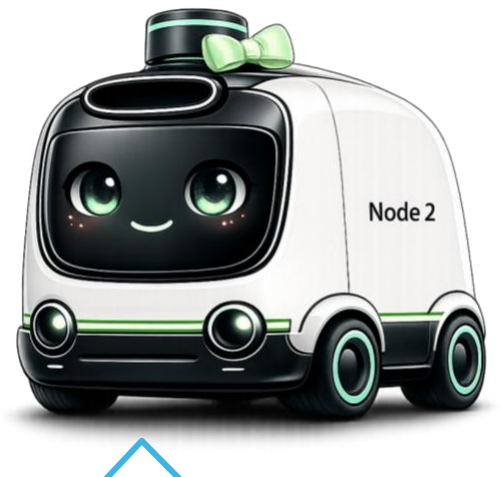
[picture p44: figure]

최세은
: 짧은 일정으로 인해
체력적으로 힘든 순간도
있었지만, 프로젝트를 끝까지
완성하면서 큰 성취감과
뿌듯함을 느낄 수 있었습니다.

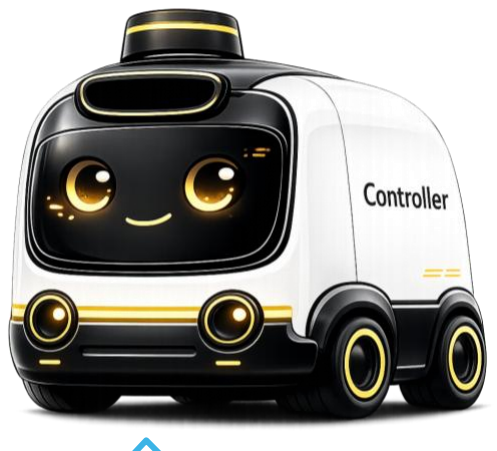
[picture p45: figure]

신동민
: 펌웨어 개발의 전체적인
워크플로우를 조금이나마
이해하고 익힐 수 있었으며,
여러 부품을 직접 연결하고
납땜하는 과정에서 하드웨어
작업 능력도 향상할 수
있었습니다.

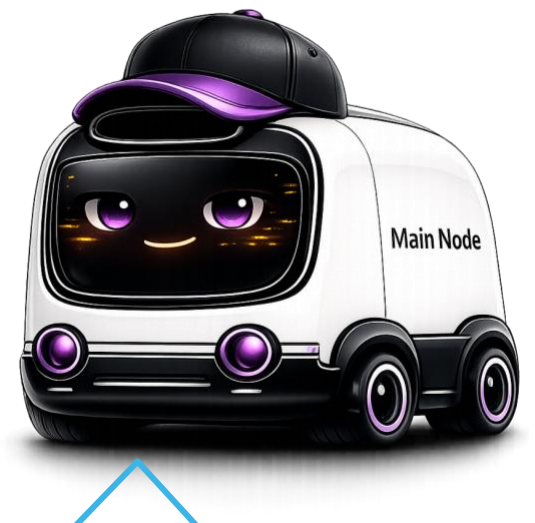
[picture p46: figure]

이정훈
: 수업 시간에 배웠던 UART,
SPI, ADC 등 다양한 통신 및
제어 방식을 실제 프로젝트에
적용해 보면서 기존에 학습했던
내용을 복습할 수 있었습니다.

# 07 Q & A

# 감사합니다 ^_________^
