Dongmins11/KickCAN_project_Controller/assets/adc-dma.png

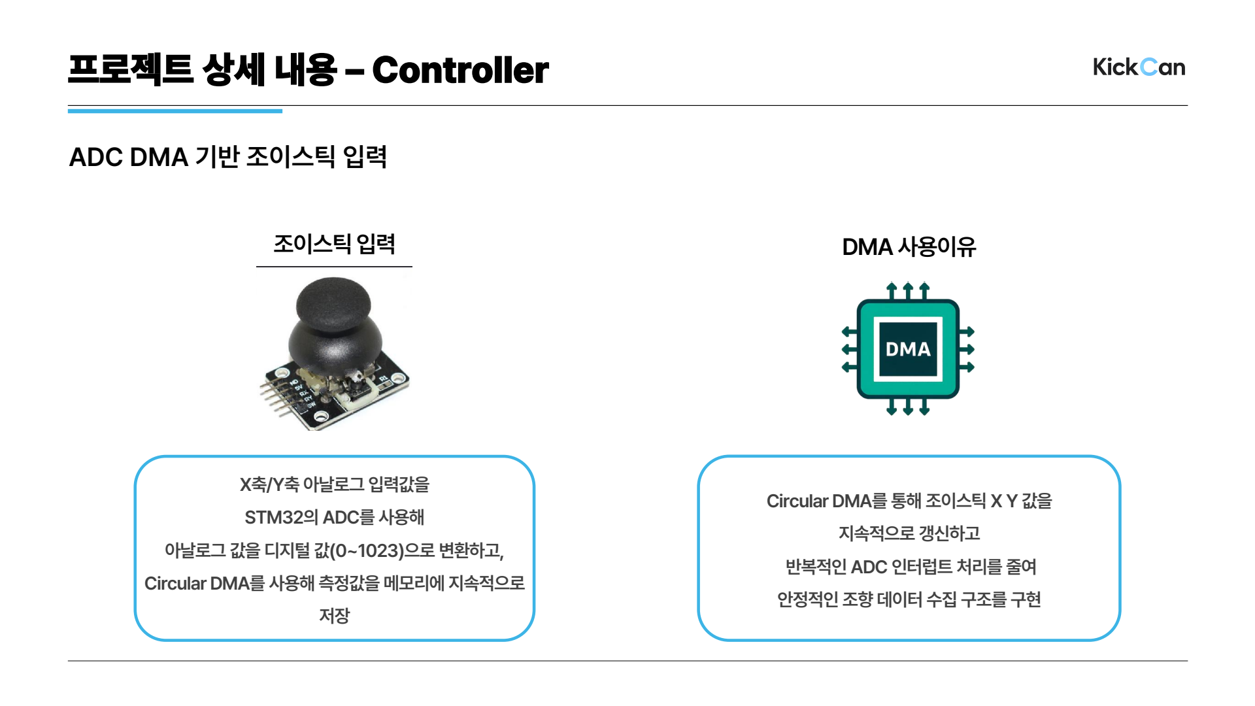
assets/adc-dma.png
