Dongmins11/KickCAN_project_Controller/assets/controller-overview.png

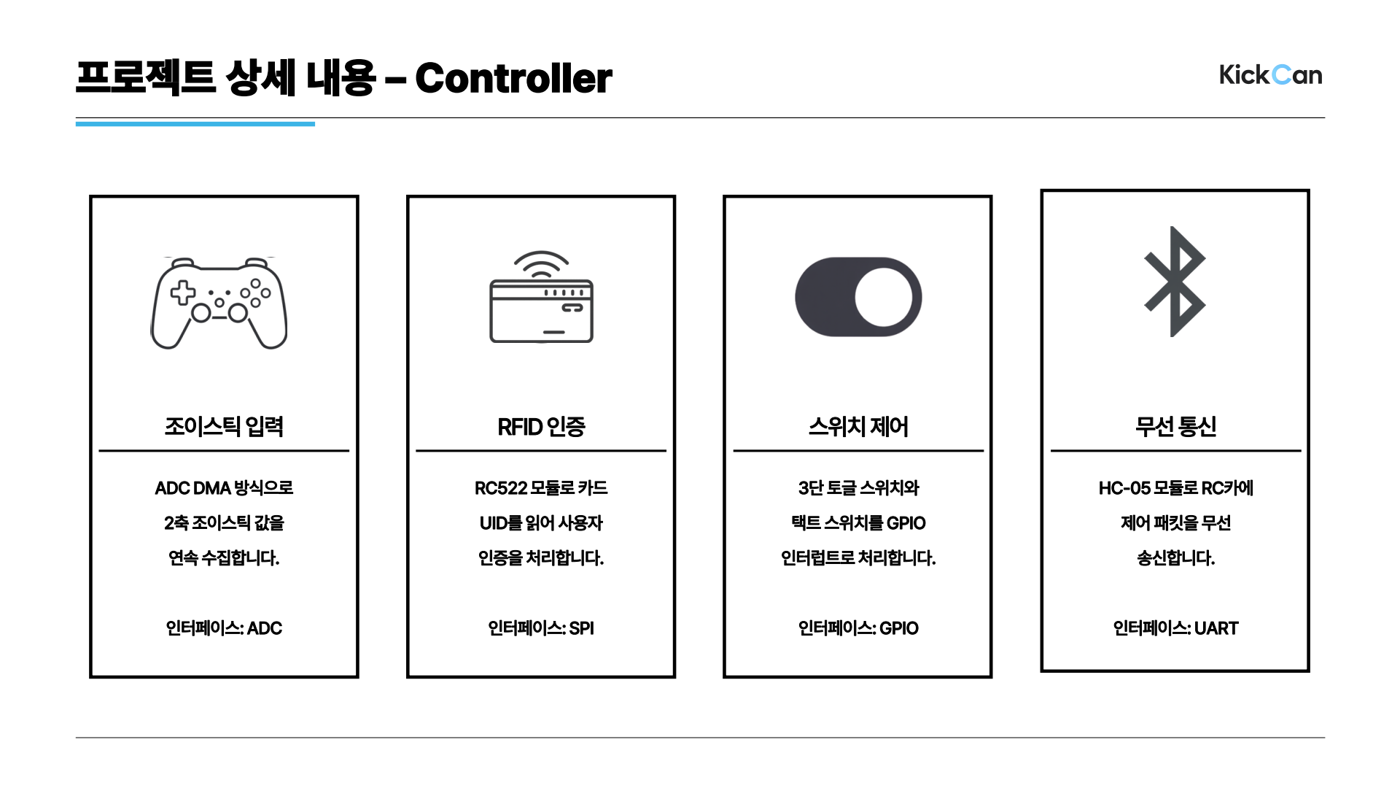
assets/controller-overview.png
