Dongmins11/KickCAN_project_Controller/docs/bom.md

# BOM · 부품 목록

[README로 돌아가기](../README.md) · [원본 Excel](files/BOM.xlsx)

원본 Excel의 셀 내용을 Markdown 표로 옮겼습니다. 설계 당시의 값·표기이며, 실제 Controller 구현과 다른 부분은 아래에 별도로 적었습니다. 원본의 서식과 삽입 그림은 Excel 파일에서 확인할 수 있습니다.

## BOM

| 연번 | 부품명 | 제조업체 | 부품 번호(MPN) | 수량 | 단가 | 총액 | 구매처 | 상태 | 비고 |
|---|---|---|---|---|---|---|---|---|---|
| 1 | NUCLEO-F411RE | STMicroelectronics | NUCLEO-F411RE | 1 | 38000 | 38000 | 디바이스 마트 | 재고 있음 | — |
| 2 | NUCLEO-F103RB | STMicroelectronics | NUCLEO-F103RB | 2 | 58000 | 116000 | 디바이스 마트 | 재고 있음 | — |
| 3 | STM32H523 | WeAct Studio | STM32H523CET6 | 1 | 9062 | 9062 | 알리바바 | 재고 있음 | — |
| 4 | 아두이노 4WD 주행로봇 프레임 세트 | SMG |  SZH-EK098 | 2 | 8300 | 16600 | 디바이스 마트 | 재고 있음 | — |
| 5 | 블루투스 모듈 | LK EMBEDDED | HC-05 B36 | 2 | 6000 | 12000 | 디바이스 마트 | 재고 있음 | — |
| 6 | l298N | SMG | SZH-EK001 | 1 | 2700 | 2700 | 디바이스 마트 | 재고 있음 | — |
| 7 | Toggle 3단3P 스위치 | 우진전기 | WTS-3303S | 1 | 2600 | 2600 | 디바이스 마트 | 재고 있음 | — |
| 8 | 온도센서 | Analog Devices Inc | TMP36GT9Z | 1 | 2400 | 2400 | 디바이스 마트 | 재고 있음 | — |
| 9 | RFID 센서 | Voltly | RC522 VLT-RF009 | 1 | 2000 | 2000 | 디바이스 마트 | 재고 있음 | — |
| 10 | 초음파센서 | SMG-A | HC-SR04P | 2 | 1100 | 2200 | 디바이스 마트 | 재고 있음 | — |
| 11 | PS2 조이스틱 | SMG-A | SZH-EK056 | 1 | 1000 | 1000 | 디바이스 마트 | 재고 있음 | — |
| 12 | 조도센서 | OEM | GL5537 | 2 | 500 | 1000 | 디바이스 마트 | 재고 있음 | — |
| 13 | 4핀 택트스위치 | OEM | SZH-TH0018 | 10 | 200 | 2000 | 디바이스 마트 | 재고 있음 | — |
| 14 | 원형 노브 캡  | NW3 | NW3-A95 | 10 | 50 | 500 | 디바이스 마트 | 재고 있음 | — |
| 15 | 세라믹 0.1㎌ 캐패시터 | SAMWON | — | 10 | 30 | 300 | 디바이스 마트 | 재고 있음 | — |
| 16 | I2C 1602 LCD | SMG | SZH-EK101 | 1 | 2500 | 2500 | 디바이스 마트 | 재고 있음 | — |
| 17 | SPI TFT LCD | SMG | SZH-EK096 | 2 | 15000 | 30000 | 디바이스 마트 | 재고 있음 | — |
| 18 | LED 5mm 빨간색 | DAKWANG | 5R3HT-10 | 4 | 70 | 280 | 디바이스 마트 | 재고 있음 | — |
| 19 | LED 5mm 백색 | DAKWANG | 5BCLSC00 | 2 | 480 | 960 | 디바이스 마트 | 재고 있음 | — |
| 20 | 1/4W 5% Axial Resistor 221J (220Ω) | 제일 전자 | — | 10 | 250 | 2500 | 디바이스 마트 | 재고 있음 | — |
| 21 | 1/4W 5% Axial Resistor 102J (1KΩ) | 제일 전자 | — | 10 | 250 | 2500 | 디바이스 마트 | 재고 있음 | — |
| 22 | 1/4W 5% Axial Resistor 104J (100KΩ) | 제일 전자 | — | 10 | 250 | 2500 | 디바이스 마트 | 재고 있음 | — |

## 현재 코드와의 차이

부품 수량과 가격은 원본에 기록된 값입니다. 프로젝트 총비용이나 Controller만의 부품 수량으로 다시 집계하지 않았습니다. 릴레이는 발표자료·Controller 코드에 등장하지만 이 BOM의 부품 행에는 없습니다.
