Dongmins11/KickCAN_project_Controller/Core/Inc/main.h

#define B1_Pin GPIO_PIN_13
#define B1_GPIO_Port GPIOC
#define PC0_A5_RELAY_Pin GPIO_PIN_0
#define PC0_A5_RELAY_GPIO_Port GPIOC
#define PC1_A4_TurnR_Pin GPIO_PIN_1
#define PC1_A4_TurnR_GPIO_Port GPIOC
#define PC1_A4_TurnR_EXTI_IRQn EXTI1_IRQn
#define PA2_PD1_TX_Pin GPIO_PIN_2
#define PA2_PD1_TX_GPIO_Port GPIOA
#define PA3_D0_RX_Pin GPIO_PIN_3
#define PA3_D0_RX_GPIO_Port GPIOA
#define PA4_A2_KLAXON_Pin GPIO_PIN_4
#define PA4_A2_KLAXON_GPIO_Port GPIOA
#define PA4_A2_KLAXON_EXTI_IRQn EXTI4_IRQn
#define PC5_LEDB_Pin GPIO_PIN_5
#define PC5_LEDB_GPIO_Port GPIOC
#define PB0_A3_TurnL_Pin GPIO_PIN_0
#define PB0_A3_TurnL_GPIO_Port GPIOB
#define PB0_A3_TurnL_EXTI_IRQn EXTI0_IRQn
#define PB10_D6_BEN_Pin GPIO_PIN_10
#define PB10_D6_BEN_GPIO_Port GPIOB
#define PC6_LEDG_Pin GPIO_PIN_6
#define PC6_LEDG_GPIO_Port GPIOC
#define PC7_D9_RFRST_Pin GPIO_PIN_7
#define PC7_D9_RFRST_GPIO_Port GPIOC
#define PC8_LEDR_Pin GPIO_PIN_8
#define PC8_LEDR_GPIO_Port GPIOC
#define PA8_D7_RFCC_Pin GPIO_PIN_8
#define PA8_D7_RFCC_GPIO_Port GPIOA
#define PA9_D8_BTX_Pin GPIO_PIN_9
#define PA9_D8_BTX_GPIO_Port GPIOA
#define PA10_D2_BRX_Pin GPIO_PIN_10
#define PA10_D2_BRX_GPIO_Port GPIOA
#define TMS_Pin GPIO_PIN_13
#define TMS_GPIO_Port GPIOA
#define TCK_Pin GPIO_PIN_14
#define TCK_GPIO_Port GPIOA
#define SWO_Pin GPIO_PIN_3
#define SWO_GPIO_Port GPIOB
#define PB5_D4_BSTATE_Pin GPIO_PIN_5
#define PB5_D4_BSTATE_GPIO_Port GPIOB
#define PB5_D4_BSTATE_EXTI_IRQn EXTI9_5_IRQn
#define PB6_D10_RFIRQ_Pin GPIO_PIN_6
#define PB6_D10_RFIRQ_GPIO_Port GPIOB
#define PB6_D10_RFIRQ_EXTI_IRQn EXTI9_5_IRQn
