Dongmins11/KickCAN_project_Controller/My_main/RFIDCOM/RFID_Com.h

#pragma once

#include "sysconfigs.h"

typedef struct
{
    uint8_t uid[4];
    char* name;
} RFID_AuthorizedCard;

typedef enum
{
    AUTH_FAILED = 0,
    AUTH_UNLOCKED = 1,
    AUTH_LOCKED = 2,
} AUTH_TYPE;

void RFID_Process();
