Dongmins11/KickCAN_project_Controller/My_main/SWITCH/ToggleSwitch.c

#include "ToggleSwitch.h"

#include "Bt_Com.h"
#include "stm32f4xx_hal_gpio.h"


static Turn_ToggleState g_previousState = TURN_TOGGLE_NONE;

static Turn_ToggleState Toggle_ReadState(void)
{
    GPIO_PinState leftState;
    GPIO_PinState rightState;

    leftState = HAL_GPIO_ReadPin(PB0_A3_TurnL_GPIO_Port, PB0_A3_TurnL_Pin );

    rightState = HAL_GPIO_ReadPin(PC1_A4_TurnR_GPIO_Port, PC1_A4_TurnR_Pin);

    if(leftState == GPIO_PIN_SET && rightState == GPIO_PIN_RESET)
        return TURN_TOGGLE_LEFT;

    if(leftState == GPIO_PIN_RESET && rightState == GPIO_PIN_SET)
        return TURN_TOGGLE_RIGHT;

    if(leftState == GPIO_PIN_SET && rightState == GPIO_PIN_SET)
        return TURN_TOGGLE_MIDDLE;

    return TURN_TOGGLE_NONE;
}


void Toggle_SwitchInit(void)
{
    g_previousState = TURN_TOGGLE_NONE;
}

void Toggle_SwitchProgress(Protocol_DataFrame* _pOutFrame)
{
    Turn_ToggleState currentState;
    if(_pOutFrame == NULL)
        return;

    currentState = Toggle_ReadState();

    if(currentState == g_previousState)
        return;

    g_previousState = currentState;

    _pOutFrame->protocal_Id = PROTOCOL_ID_NODE_2;
    _pOutFrame->command_Id = C_TURN_SIGNAL;
    _pOutFrame->data[0] = (uint8_t)currentState;
}
