Dongmins11/KickCAN_project_Controller/(commit log)

2026-07-26 Feat : Toggle Switch Test Add
2026-07-27 Feat : Toggle switch Test2
2026-07-28 Fix : Bluetooth Fix
    [F411_Project.ioc, Joystick.c]
2026-07-29 Feat : Free rtos 처리 led처리 컨트롤러 흐름 구조 처리 완료
2026-10-03 docs: refresh KickCAN README with demo and controller design
    [BOM.xlsx, HSI_3.xlsx, ICD.xlsx, functional-spec.xlsx]
