Dongmins11/KickCAN_project_Controller/assets/project-photo-2.jpg

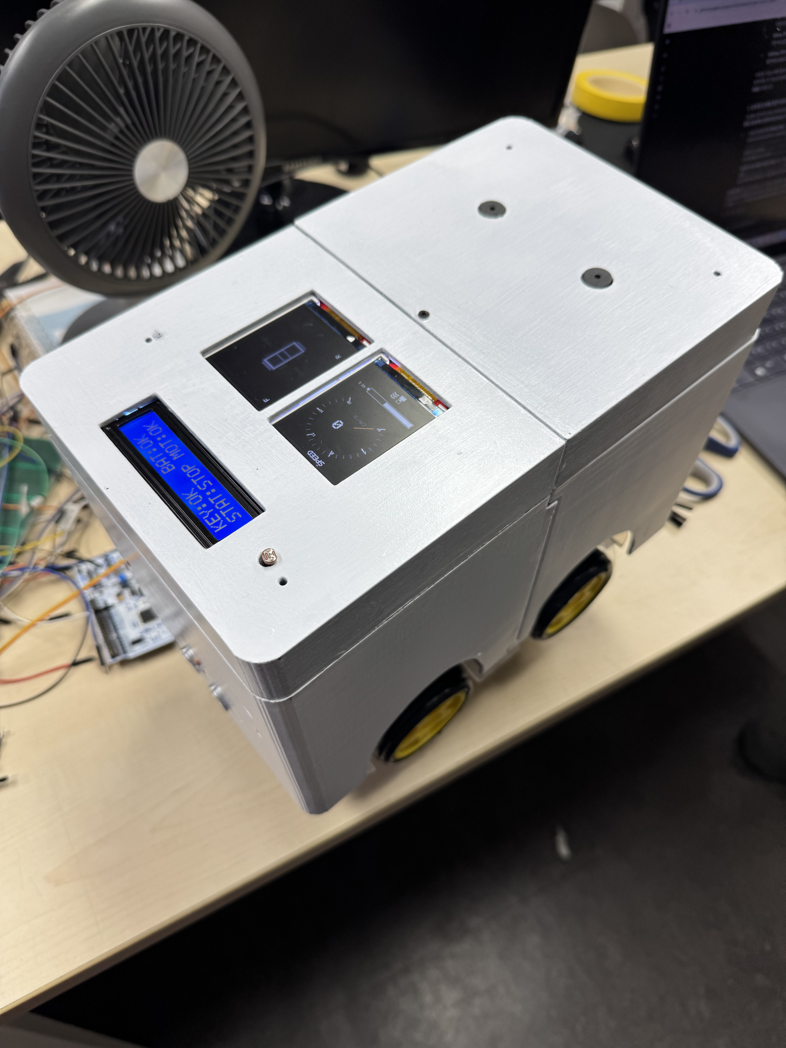
[picture p2: assets/project-photo-2.jpg]
assets/project-photo-2.jpg
